DexterInd/GoPiGo/Projects/Empathybot/README.md

# Empathybot: The Raspberry Pi Robot That Reads Human Emotion

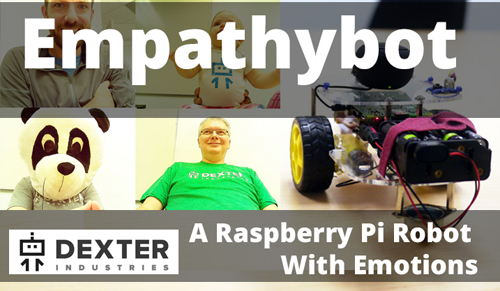
[picture p3: Projects/Empathybot/Empathybot.jpg]


In this project we built emotional intelligence to our robot.  We developed a Raspberry Pi Robot with the GoPiGo that will drive up to you, read your emotions, and then try to have a conversation with you, based on how you’re feeling.  We will show you how you too can build your own DIY emotion-reading robot with a Raspberry Pi.

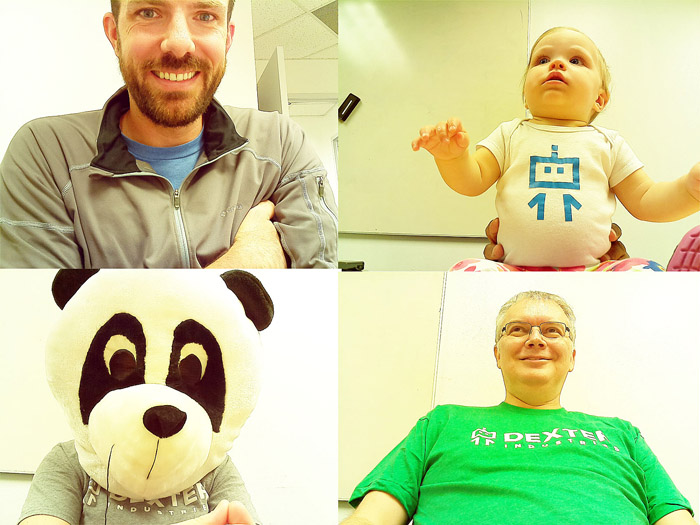
[picture p4: Projects/Empathybot/Emotions.jpg]


This folder contains the code you need to build Empathybot!  [You can see the full project here.](http://www.dexterindustries.com/projects/empathybot-raspberry-pi-robot-with-emotional-intelligence/)

# See Also

The GoPiGo is a delightful and complete robot for the Raspberry Pi that turns your Pi into a fully operating robot.  GoPiGo is a mobile robotic platform for the Raspberry Pi developed by [Dexter Industries.](http://www.dexterindustries.com/GoPiGo)  

- [Dexter Industries](http://www.dexterindustries.com/GoPiGo)
- [Kickstarter Campaign](http://kck.st/Q6vVOP)
- [Raspberry Pi](http://www.raspberrypi.org/)

## License
GoPiGo for the Raspberry Pi: an open source robotics platform for the Raspberry Pi.
Copyright (C) 2019  Dexter Industries

This program is free software: you can redistribute it and/or modify
it under the terms of the GNU General Public License as published by
the Free Software Foundation, either version 3 of the License, or
(at your option) any later version.

This program is distributed in the hope that it will be useful,
but WITHOUT ANY WARRANTY; without even the implied warranty of
MERCHANTABILITY or FITNESS FOR A PARTICULAR PURPOSE.  See the
GNU General Public License for more details.

You should have received a copy of the GNU General Public License
along with this program.  If not, see <http://www.gnu.org/licenses/gpl-3.0.txt>.
