DexterInd/GoPiGo/Projects/Alexabot/README.md

# [ Alexabot ](https://www.dexterindustries.com/projects/alexabot-amazon-alexa-controlled-robot/)

In this tutorial we build [Alexabot, the Amazon Alexa Controlled Robot, using the Raspberry Pi](https://www.dexterindustries.com/projects/alexabot-amazon-alexa-controlled-robot/).  We will walk through the steps of building a voice controlled robot with the Raspberry Pi and GoPiGo.  With Alexabot, you can command the Raspberry Pi Robot around with commands like “Alexa Forward!” or “Alexa Coffee!”.  GoPiGo is a mobile robotic platform for the Raspberry Pi developed by [Dexter Industries.](http://www.dexterindustries.com/GoPiGo)  

GoPiGo

This repository contains the code for the Alexabot Project for the GoPiGo.

GoPiGo

# See Also

- [Dexter Industries] (http://www.dexterindustries.com/GoPiGo)
- [Kickstarter Campaign] (http://kck.st/Q6vVOP)
- [Raspberry Pi] (http://www.raspberrypi.org/)

## License
GoPiGo for the Raspberry Pi: an open source robotics platform for the Raspberry Pi.
Copyright (C) 2016  Dexter Industries

This program is free software: you can redistribute it and/or modify
it under the terms of the GNU General Public License as published by
the Free Software Foundation, either version 3 of the License, or
(at your option) any later version.

This program is distributed in the hope that it will be useful,
but WITHOUT ANY WARRANTY; without even the implied warranty of
MERCHANTABILITY or FITNESS FOR A PARTICULAR PURPOSE.  See the
GNU General Public License for more details.

You should have received a copy of the GNU General Public License
along with this program.  If not, see <http://www.gnu.org/licenses/gpl-3.0.txt>.
