DexterInd/GoPiGo/Projects/GiftBot/README.md

# GiftBot

In this project, we'll show you GiftBot, the Raspberry Pi Robot that will deliver your Christmas Gifts and bring cheer to your holiday season.  We took the GoPiGo Raspberry Pi Robot, added some Jingle Bell Rock with the Raspberry Pi Speaker, and harnessed the power of three reindeer to deliver our gifts this year.  A elf will ride on the GoPiGo as it makes its rounds.

No reindeer robot would be complete without a Red Nosed Rudolf: we added one with a Red Grove LED!  GoPiGo is a mobile robotic platform for the Raspberry Pi developed by [Dexter Industries.](http://www.dexterindustries.com/GoPiGo)  

You can see [the full project for the GiftBot Raspberry Pi Robot here.](https://www.dexterindustries.com/projects/giftbot-raspberry-pi-robot-delivers-christmas-gifts/)

GoPiGo

This repository contains project examples for the GoPiGo.

GoPiGo

# See Also

- [Dexter Industries] (http://www.dexterindustries.com/GoPiGo)
- [Kickstarter Campaign] (http://kck.st/Q6vVOP)
- [Raspberry Pi] (http://www.raspberrypi.org/)

## License
GoPiGo for the Raspberry Pi: an open source robotics platform for the Raspberry Pi.
Copyright (C) 2016  Dexter Industries

This program is free software: you can redistribute it and/or modify
it under the terms of the GNU General Public License as published by
the Free Software Foundation, either version 3 of the License, or
(at your option) any later version.

This program is distributed in the hope that it will be useful,
but WITHOUT ANY WARRANTY; without even the implied warranty of
MERCHANTABILITY or FITNESS FOR A PARTICULAR PURPOSE.  See the
GNU General Public License for more details.

You should have received a copy of the GNU General Public License
along with this program.  If not, see <http://www.gnu.org/licenses/gpl-3.0.txt>.
