DexterInd/GoPiGo/Software/Python/Examples/Basic_Robot_Control_GUI/README.md

## Basic Robot Control GUI
### Basic example for controlling the GoPiGo using the Keyboard and a GUI on VNC

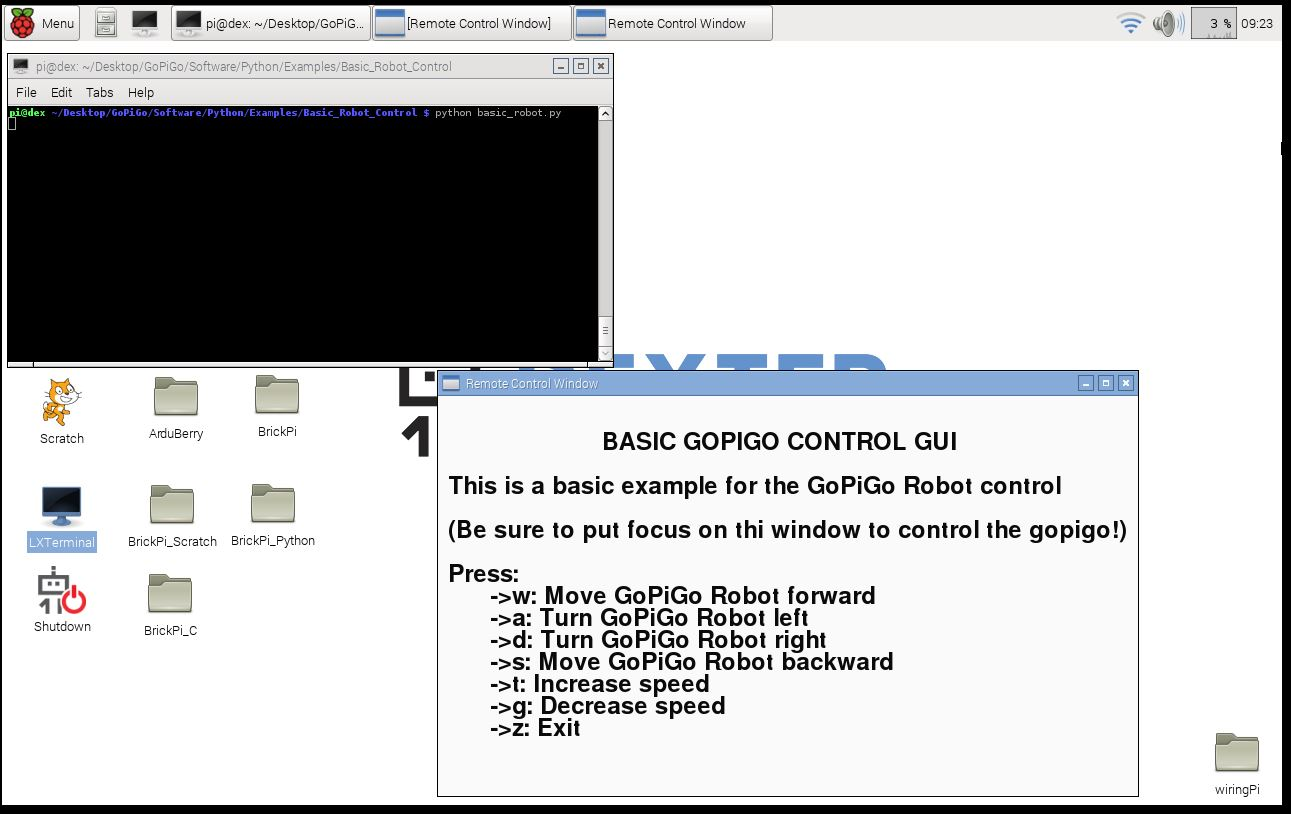
[picture p9: Software/Python/Examples/Basic_Robot_Control_GUI/Basic_Raspberry_Pi_Robot_Control_GUI.jpg]
Basic Robot Control GUI GoPiGo Rasberry Pi Robot Controlled with a GUI


Contributed by casten on Gitub https://github.com/DexterInd/GoPiGo/pull/112

**Control:**

- w:	Move forward
- a:	Turn left
- d:	Turn right
- s:	Move back
- x:	Stop
- t:	Increase speed
- g:	Decrease speed
- z: 	Exit

**Usage:**
Open LXTerminal in VNC or Pi Desktop

Go to the example folder:

`cd Desktop/GoPiGo/Software/Python/Examples/Basic_Robot_Control/GUI`

Run the example:

`python basic_robot_gui.py`

GoPiGo

This repository contains source code, firmware and design materials for the GoPiGo.

GoPiGo

# See Also

- [Dexter Industries](http://www.dexterindustries.com/GoPiGo)
- [Kickstarter Campaign](http://kck.st/Q6vVOP)
- [Raspberry Pi](http://www.raspberrypi.org/)

## License
GoPiGo for the Raspberry Pi: an open source robotics platform for the Raspberry Pi.
Copyright (C) 2015  Dexter Industries

This program is free software: you can redistribute it and/or modify
it under the terms of the GNU General Public License as published by
the Free Software Foundation, either version 3 of the License, or
(at your option) any later version.

This program is distributed in the hope that it will be useful,
but WITHOUT ANY WARRANTY; without even the implied warranty of
MERCHANTABILITY or FITNESS FOR A PARTICULAR PURPOSE.  See the
GNU General Public License for more details.

You should have received a copy of the GNU General Public License
along with this program.  If not, see <http://www.gnu.org/licenses/gpl-3.0.txt>.
