DexterInd/GoPiGo/Software/Python/Examples/Basic_Servo/README.md

## basic_servo.py
### This example demonstrates controlling the Servo on the GoPiGo robot.
In this example, we control the servo with a keyboard. 
- Press "a" to move the servo left
- Press "d" to move the servo right
- Press "s" to move the servo to home position

GoPiGo

This repository contains source code, firmware and design materials for the GoPiGo.

GoPiGo

# See Also

- [Dexter Industries](http://www.dexterindustries.com/GoPiGo)
- [Kickstarter Campaign](http://kck.st/Q6vVOP)
- [Raspberry Pi](http://www.raspberrypi.org/)

## License
GoPiGo for the Raspberry Pi: an open source robotics platform for the Raspberry Pi.
Copyright (C) 2015  Dexter Industries

This program is free software: you can redistribute it and/or modify
it under the terms of the GNU General Public License as published by
the Free Software Foundation, either version 3 of the License, or
(at your option) any later version.

This program is distributed in the hope that it will be useful,
but WITHOUT ANY WARRANTY; without even the implied warranty of
MERCHANTABILITY or FITNESS FOR A PARTICULAR PURPOSE.  See the
GNU General Public License for more details.

You should have received a copy of the GNU General Public License
along with this program.  If not, see <http://www.gnu.org/licenses/gpl-3.0.txt>.
