DexterInd/GoPiGo/Software/Python/Examples/Browser_Streaming_Robot/README.md

## Browser streaming bot
### This example is for streaming video and controlling the GoPiGo from a web browser

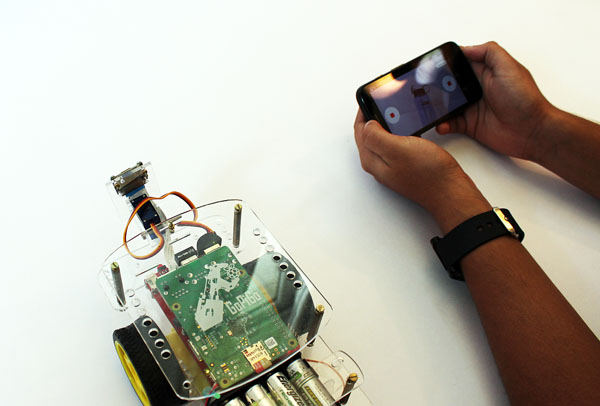
[picture p10: Software/Python/Examples/Browser_Streaming_Robot/Raspberry_Pi_Camera_controlled-by-mobile-browser.jpg]
Mobile control of the GoPiGo Raspberry Pi Robot Control of the GoPiGo Raspberry Pi Robot with a mobile phone.


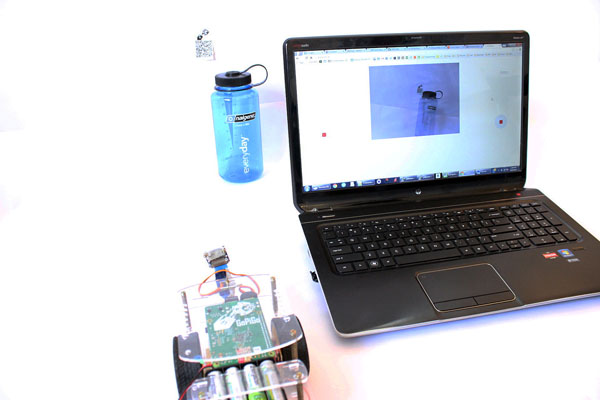
[picture p11: Software/Python/Examples/Browser_Streaming_Robot/Raspberry_Pi_Camera_streaming-to-computer-browser.jpg]
Robot Control and streaming through the browser Streaming video through the browser of the GoPiGo


Controlling the GoPiGo robot with a mobile phone Streaming video from your Raspberry Pi Robot to your mobile phone.

**Usage:**
- Make robot_web_server.py executable

 >      sudo chmod +x robot_web_server.py

- Run robot_web_server.py

 >      sudo ./robot_web_server.py
 
- Open a web browser on any computer or mobile device and enter the following in the address bar:

 >      dex.local:98
The page runs on dex.local or the IP address of the Pi on port 98

- The video stream would load up and you can use the joystick on the screen to control the GoPiGo

GoPiGo

This repository contains source code, firmware and design materials for the GoPiGo.

GoPiGo

# See Also

- [Dexter Industries](http://www.dexterindustries.com/GoPiGo)
- [Kickstarter Campaign](http://kck.st/Q6vVOP)
- [Raspberry Pi](http://www.raspberrypi.org/)

## License
GoPiGo for the Raspberry Pi: an open source robotics platform for the Raspberry Pi.
Copyright (C) 2017  Dexter Industries

This program is free software: you can redistribute it and/or modify
it under the terms of the GNU General Public License as published by
the Free Software Foundation, either version 3 of the License, or
(at your option) any later version.

This program is distributed in the hope that it will be useful,
but WITHOUT ANY WARRANTY; without even the implied warranty of
MERCHANTABILITY or FITNESS FOR A PARTICULAR PURPOSE.  See the
GNU General Public License for more details.

You should have received a copy of the GNU General Public License
along with this program.  If not, see <http://www.gnu.org/licenses/gpl-3.0.txt>.
