DexterInd/GoPiGo/Software/Python/Examples/Mouse_Control/README.md

## Mouse Control
### This example controls the GoPiGo with a wireless mouse on the USB port.

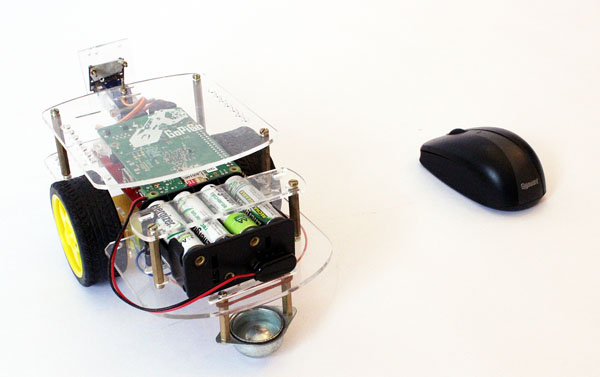
[picture p13: Software/Python/Examples/Mouse_Control/GoPiGo-Mouse-Control-with-Raspberry-Pi.jpg]
Control the Raspberry Pi Robot with a mouse. Control the Raspberry Pi Robot with a mouse.


**mouse_control_movement.py**

- Move the mouse up, down, left or right to control the GoPiGo
- Press the Left mouse button to stop

**mouse_control_movement.py**

- Press _any mouse_ button to start moving
- Press the _Left mouse_ button to turn left
- Press the _Right mouse_ button to turn right
- Press the _Middle mouse_ button to stop
- Press both _left and right mouse_ button to move back

GoPiGo

This repository contains source code, firmware and design materials for the GoPiGo.

GoPiGo

# See Also

- [Dexter Industries](http://www.dexterindustries.com/GoPiGo)
- [Kickstarter Campaign](http://kck.st/Q6vVOP)
- [Raspberry Pi](http://www.raspberrypi.org/)

## License
GoPiGo for the Raspberry Pi: an open source robotics platform for the Raspberry Pi.
Copyright (C) 2017  Dexter Industries

This program is free software: you can redistribute it and/or modify
it under the terms of the GNU General Public License as published by
the Free Software Foundation, either version 3 of the License, or
(at your option) any later version.

This program is distributed in the hope that it will be useful,
but WITHOUT ANY WARRANTY; without even the implied warranty of
MERCHANTABILITY or FITNESS FOR A PARTICULAR PURPOSE.  See the
GNU General Public License for more details.

You should have received a copy of the GNU General Public License
along with this program.  If not, see <http://www.gnu.org/licenses/gpl-3.0.txt>.
