DexterInd/GoPiGo/Projects/AgentKK/README.md

# Agent KK Guard Robot

Build and program this little GoPiGo to protect your wardrobe, your closet, or even your whole room! Hide GoPiGo behind a closed door and when the door is opened, it will attack your siblings, scaring them, and even taking a picture as trespassing proof! That way, even mom will have to be on your side! 

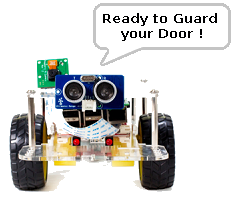
[picture p16: Projects/AgentKK/ReadyToGuardYourDoor.png]
GoPiGo


This repository contains the code for this project in both Python and Scratch. 
The sound effect comes from https://www.freesound.org/

The project is documented at [AgentKK](http://www.dexterindustries.com/projects/agent-kk-2/)

GoPiGo is documented at [GoPiGo](http://www.dexterindustries.com/shop/gopigo-starter-kit-2/)

# See Also

- [Dexter Industries](http://www.dexterindustries.com/GoPiGo)
- [Kickstarter Campaign](http://kck.st/Q6vVOP)
- [Raspberry Pi](http://www.raspberrypi.org/)

## License
GoPiGo for the Raspberry Pi: an open source robotics platform for the Raspberry Pi.
Copyright (C) 2016  Dexter Industries

This program is free software: you can redistribute it and/or modify
it under the terms of the GNU General Public License as published by
the Free Software Foundation, either version 3 of the License, or
(at your option) any later version.

This program is distributed in the hope that it will be useful,
but WITHOUT ANY WARRANTY; without even the implied warranty of
MERCHANTABILITY or FITNESS FOR A PARTICULAR PURPOSE.  See the
GNU General Public License for more details.

You should have received a copy of the GNU General Public License
along with this program.  If not, see <http://www.gnu.org/licenses/gpl-3.0.txt>.
