DexterInd/GoPiGo/Software/Python/control_panel/GoPiGo.png

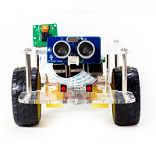
Software/Python/control_panel/GoPiGo.png
