DexterInd/GoPiGo/Software/Python/Examples/Browser_Streaming_Robot/Raspberry_Pi_Camera_streaming-to-mobile-browser.jpg

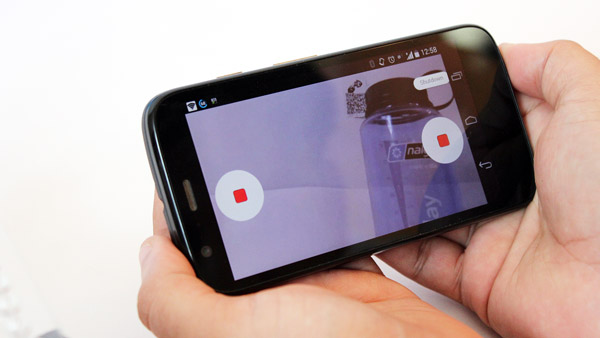
Software/Python/Examples/Browser_Streaming_Robot/Raspberry_Pi_Camera_streaming-to-mobile-browser.jpg
