DexterInd/GoPiGo/Assembly_and_Programming/README.md

# GoPiGo Assembly and Programming Instructions

The GoPiGo is a delightful and complete robot for the Raspberry Pi that turns your Pi into a fully operating robot.  GoPiGo is a mobile robotic platform for the Raspberry Pi developed by [Dexter Industries.](http://www.dexterindustries.com/GoPiGo)  

GoPiGo

# Assembly and Programming Files

These files were originally hosted on the Dexter Industries website.  With the introduction of the GoPiGo3, we have migrated all assembly and startup instructions to Github in PDF format.  

You can find a series of helpful videos for assembling and getting started with the GoPiGo1 and GoPiGo2 on Youtube:
1. [Assemble the GoPiGo1](https://www.youtube.com/playlist?list=PLGXEJ4Ye1qCOs-fSJRosUp4GyvH-XZrSS)
2. [Assemble the GoPiGo2](https://www.youtube.com/playlist?list=PLGXEJ4Ye1qCP_hewmQsEGqpzLr0Ydy8_O)
3. [Connect to the GoPiGo2](https://www.youtube.com/playlist?list=PLGXEJ4Ye1qCNZ9OGYTXh7o8jSgO5-NHjY).

# See Also

- [The GoPiGo3](http://www.dexterindustries.com/GoPiGo)
- [Dexter Industries Forum Support](http://forum.dexterindustries.com/c/gopigo)
- [Kickstarter Campaign](http://kck.st/Q6vVOP)
- [Raspberry Pi](http://www.raspberrypi.org/)

## License
GoPiGo for the Raspberry Pi: an open source robotics platform for the Raspberry Pi.
Copyright (C) 2017  Dexter Industries

This program is free software: you can redistribute it and/or modify
it under the terms of the GNU General Public License as published by
the Free Software Foundation, either version 3 of the License, or
(at your option) any later version.

This program is distributed in the hope that it will be useful,
but WITHOUT ANY WARRANTY; without even the implied warranty of
MERCHANTABILITY or FITNESS FOR A PARTICULAR PURPOSE.  See the
GNU General Public License for more details.

You should have received a copy of the GNU General Public License
along with this program.  If not, see <http://www.gnu.org/licenses/gpl-3.0.txt>.
