DexterInd/GoPiGo/Assembly_and_Programming/GoPiGo2/Assembly_and_Getting_Started/dexterindustries.com-Add trim to the motors.pdf

# Add trim to the motors

dexterindustries.com/GoPiGo/programming__trashed/python-programming-for-the-raspberry-pigopigo__trashed/add-trim-to-the-motors/ (https://www.dexterindustries.com/GoPiGo/programming__trashed/python-programming-for-the-raspberry-pi-gopigo__trashed/add-trim-to-the-motors/)

If you find that your GoPiGo starts turning a bit when it moves forward then this is something for you.

We have added a trim function in the Firmware and the software from firmware v1.3 on wards so that you can increase or decrease the speed of one of the wheels just by a bit (add trim) so it does not turn by a lot when it is moving forward. The GoPiGo usually starts going a bit left or right because of a lot of external factors like the wheel alignment, motor placement, friction etc.

Here is how to use trim with your GoPiGo.

Before you start, make sure that you disconnect the motors. When the firmware update is done and you have verified that it has upgraded, connect the motors again.

Make sure that you have updated to firmware v1.3.

cd Desktop/GoPiGo/Firmware sudo chmod +x firmware_update.sh

sudo ./firmware_update.sh

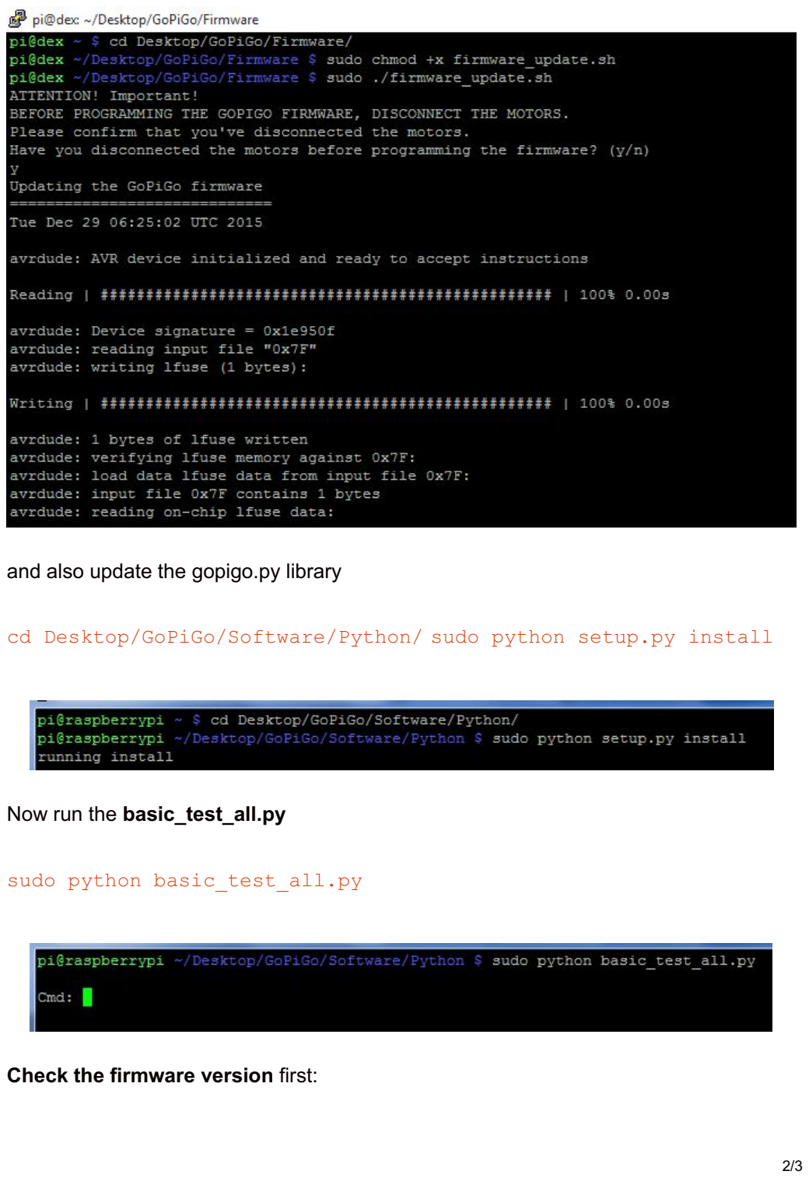
[picture p62: page 2]

and also update the gopigo.py library

cd Desktop/GoPiGo/Software/Python/ sudo python setup.py install

Now run the basic_test_all.py

sudo python basic_test_all.py

Check the firmware version first:

Then check for the trim value with the tr command:

Now you should try various trim values to see what works for you.

A trim value of 0 means that the left motor will run at
the same speed as the right motor.
A trim value of 50 means that the left motor will run at the 150% the speed of the right motor and the GoPiGo will turn more towards the right. This can be used to compensate for the GoPiGo normally turning left when it is supposed to go right. A trim value of -50 means that the left motor will run at the 50% the speed of the right motor and the GoPiGo will turn more towards the left. This can be used to compensate for the GoPiGo normally turning right when it is supposed to go left. Start with small trim values in multiple of 5 and find out the value that works for you
Give w to move forward and x to stop to test the trim values

Once you have found the trim value that
works best for you, write it to the
EEPROM so that the GoPiGo uses
them whenever it starts:

Give tw as the command and enter the
desired trim value. If it reports back that
the value in EEPROM is the same as the value you gave, that means that you have set the values correctly.

The values revert back to 0 whenever yo do a firmware update.
