DexterInd/GoPiGo/Assembly_and_Programming/GoPiGo2/Assembly_and_Getting_Started/dexterindustries.com-Attaching a Camera or Ultrasonic Sensor.pdf

# Attaching a Camera or Ultrasonic Sensor

dexterindustries.com/GoPiGo/getting-started-with-your-gopigo-raspberry-pi-robot-kit-2/attaching-a-cameraor-ultrasonic-sensor-raspberry-pi-robot-kit/ (https://www.dexterindustries.com/GoPiGo/getting-started-with-your-gopigo-raspberry-pi-robot-kit-2/attaching-a-camera-or-ultrasonic-sensor-raspberry-pi-robot-k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)

How to turn your Raspberry Pi into a Camera or ultrasonic sensor guided robot.

### Attach the Raspberry Pi Camera With the Servo

Start with the Raspberry Pi Camera.

This tutorial assumes you have already built
the servo package. For instructions on building the servo package please see this. (https://www.dexterindustries.com/GoPiGo/getting-started-with-your-gopigo-raspberry-pi-robot-kit/1-assemble-the-gopigo/assemble-servo-package-assemble-the-rasp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)

Attach the camera to the faceplate of the servo package using two of the small screws
attached. You can properly space the camera
from the servo faceplate by attaching the

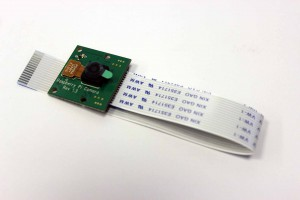
[picture p85: figure]

screws to the camera first, then attaching a nut against the camera.

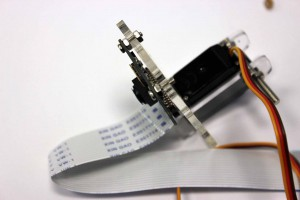
[picture p86: figure]

Attach the camera to the faceplate.

Connecting the servo to the GoPiGo board. Note the orientation of the brown wire.

### Attach the Camera Directly to the Chassis

### Attach the Ultrasonic Sensor

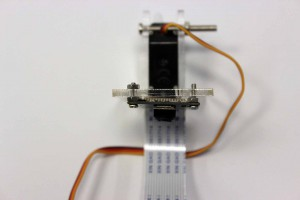
[picture p87: figure]

The ultrasonic sensor can be attached to the servo faceplate with two of the screws that come with the servo package. The ultrasonic sensor has two screw holes to allow for attaching.

Connect the servo to the GoPiGo Board.

### Questions about the Raspberry Pi Robot Kit?

Please ask away on our forums! (https://www.dexterindustries.com/forum/?forum=gopigo)

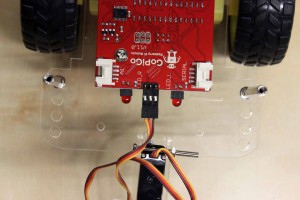
[picture p88: figure]
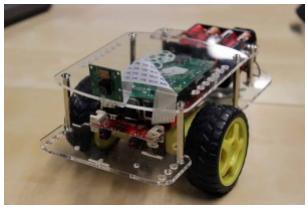
[picture p89: figure]

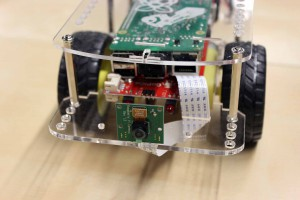
[picture p90: figure]

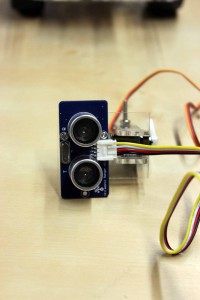
[picture p91: figure]
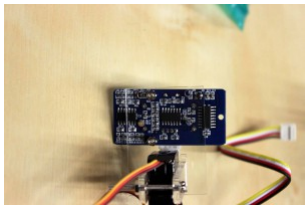
[picture p92: figure]
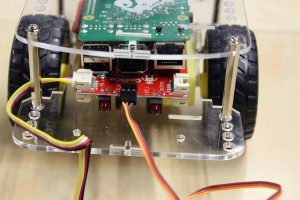
[picture p93: figure]
