DexterInd/GoPiGo/Assembly_and_Programming/GoPiGo2/Assembly_and_Getting_Started/dexterindustries.com-Get Started With the GoPiGo.pdf

# Get Started With the GoPiGo

dexterindustries.com/GoPiGo/getting-started-with-your-gopigo-raspberry-pi-robot-kit-2/

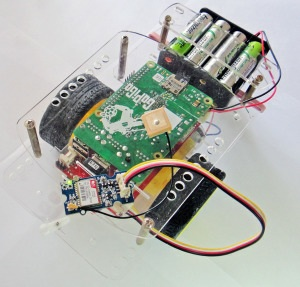
[picture p94: figure]

Congratulations on getting a GoPiGo
Raspberry Pi Robot Kit!

This page and the sub-pages will help walk you through getting it setup and started. We recommend you go through each page, in the following order:

1. Assemble the GoPiGo (https://www.dexterindustries.com/GoPiGo/1-assemble-the-gopigo/) Raspberry Pi Robot Kit & Servo.
2. Setting up the SD Card. (https://www.dexterindustries.com/GoPiGo/sdcard/)
3. Powering Up the GoPiGo. (https://www.dexterindustries.com/GoPiGo/3-power-up/)
4. Connect to the GoPiGo. (https://www.dexterindustries.com/GoPiGo/4-connect-to-the-gopigo/)
5. Booting the GoPiGo for the first time. (https://www.dexterindustries.com/GoPiGo/5-using-your-gopigo-for-the-first-time/)

After you have completed all the steps above, you can check out the Examples and Projects that we have made and try them out yourself or make something cool and (https://www.dexterindustries.com/GoPiGo/learning/python-examples-for-the-raspberry-pi/) share it with the community.

Have a question or a suggestion? Go check out our forums here. (http://forum.dexterindustries.com/)

1/1
