DexterInd/GoPiGo/Assembly_and_Programming/GoPiGo2/Programming/Python/dexterindustries.com-fw_ver.pdf

# fw_ver()

dexterindustries.com/GoPiGo/learning-2/python-programming-for-the-raspberry-pi-gopigo/fw_ver/

### Read the firmware version of the GoPiGo

Read the firmware version of the GoPiGo.

It can be from 0.9 onwards.

1.0 is the latest firmware

Syntax

fw_ver()

Parameter:

None

Return:

Firmware version on success

-1 on failure

Example

from gopigo import *
print fw_ver()

1/1
