DexterInd/GoPiGo/Assembly_and_Programming/GoPiGo2/Programming/Python/dexterindustries.com-Read communication timeoutnbspstatus.pdf

# Read communication timeout status

dexterindustries.com/GoPiGo/learning-2/python-programming-for-the-raspberry-pigopigo/read_timeout_status/ (https://www.dexterindustries.com/GoPiGo/learning-2/python-programming-for-the-raspberry-pi-gopigo/read_timeout_status/)

Reads status register on the GoPiGo and returns the status of the communication timeout

Syntax

read_timeout_status()

Parameter:

None

Return:

0 if the communication timeout has occurred, else 1

Example

from gopigo import *
print read_timeout_status()

1/1
