DexterInd/GoPiGo/Assembly_and_Programming/GoPiGo2/Programming/Python/dexterindustries.com-Read encoder targeting status.pdf

# Read encoder targeting status

dexterindustries.com/GoPiGo/learning-2/python-programming-for-the-raspberry-pigopigo/read_enc_status/ (https://www.dexterindustries.com/GoPiGo/learning-2/python-programming-for-the-raspberry-pi-gopigo/read_enc_status/)

Reads status register on the GoPiGo and returns the status of the encoder targeting

Syntax

read_enc_status()

Parameter:

None

Return:

0 if encoder target is reached, else 1

Example

from gopigo import *
print read_enc_status()

1/1
