DexterInd/GoPiGo/Assembly_and_Programming/GoPiGo2/Programming/Python/dexterindustries.com-Read encoder values.pdf

# Read encoder values

dexterindustries.com/GoPiGo/learning-2/python-programming-for-the-raspberry-pi-gopigo/read-encodervalues/ (https://www.dexterindustries.com/GoPiGo/learning-2/python-programming-for-the-raspberry-pi-gopigo/read-encoder-values/)

GoPiGo Firmware update 1.3 onward, it is now possible to access the encoder vales easily.

Just make sure that you are using firmware version 1.3 and goto the Software/Python folder on your Pi

cd Desktop/GoPiGo/Software/Python/

and run the encoder read example:

sudo python enc_val_read.py

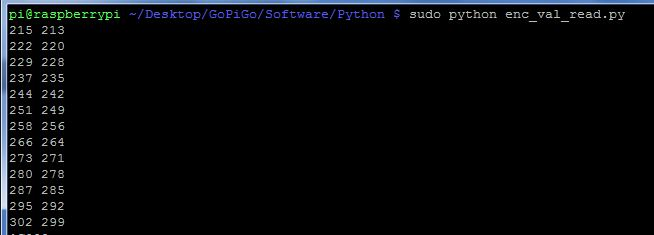
[picture p95: figure]

It gives you the values for both the encoders. 18 counts on the encoder correspond to 1 rotation of the wheel.

1/1
