DexterInd/GoPiGo/Assembly_and_Programming/GoPiGo2/Programming/Python/dexterindustries.com-Installing the GoPiGo Python Library.pdf

# Installing the GoPiGo Python Library

dexterindustries.com/GoPiGo/learning-2/python-programming-for-the-raspberry-pi-gopigo/installinggopigo-python-library/ (https://www.dexterindustries.com/GoPiGo/learning-2/python-programming-for-the-raspberry-pi-gopigo/installing-gopigo-python-library/)

If you are using the Dexter Industries SD card or the Dexter Industries Image, then the GoPiGo library comes preinstalled with the SD card.

If you are using your own version of Raspbian then you will have to install the Python Library

To install the GoPiGo library:

1. Clone the GoPiGo Repository from Github

sudo git clone https://github.com/DexterInd/GoPiGo.git

2. Go to the Python folder cd GoPiGo/Software/Python/
3. Install the python library sudo python setup.py install

1/2

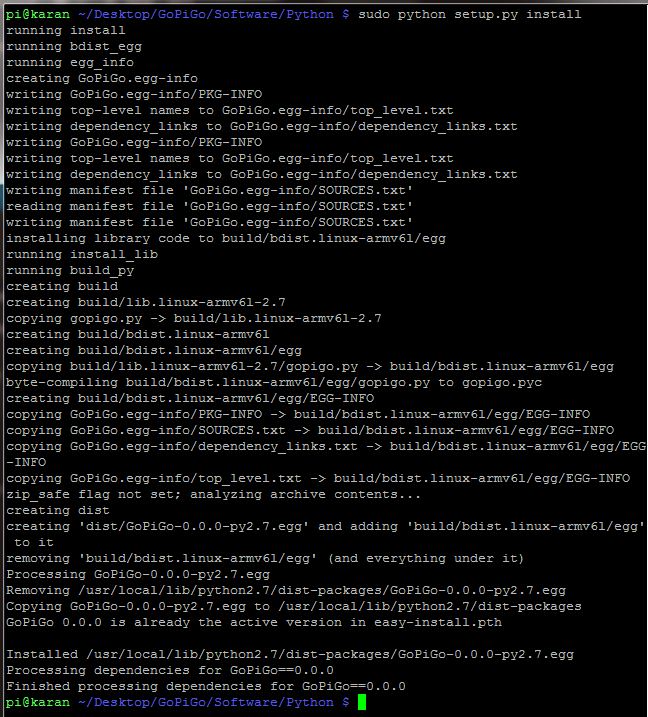
[picture p104: figure]

The library should be installed now.

Go over to the example section (https://www.dexterindustries.com/GoPiGo/learning/python-examples-for-the-raspberry-pi/) and try out some examples.

Have a question or a suggestion? Go check out our support page here (https://www.dexterindustries.com/GoPiGo/learning/) or post it on the forums here. (https://www.dexterindustries.com/forum/?forum=gopigo)

2/2
