DexterInd/GoPiGo/(threads)

Thread 20 (2014-07-08):

Improving the stability of encoder targetting

karan259, 2014-07-08:

Closed 2022-03-07.

Thread 21 (2014-07-09):

Problem with PIDafter stopping

karan259, 2014-07-09:
If motor 1 slow down and stops, motor 2 does the same but Motor 2 does not start after motor 1 starts

Closed 2015-01-12.

Thread 38 (2015-01-12):

Motor Turning at different rates and sometime stalling

karan259, 2015-01-12:
Refer to forums http://www.dexterindustries.com/forum/?reply=3787

karan259, 2015-01-12:
Solution for now is to switch to Normal running mode without PID for default and keep looking into the issue.

Closed 2015-01-12.

Thread 52 (2015-05-16):

Firmware version mismatch

BandonRandon, 2015-05-16:
Today I got out my GoPiGo and noticed that v13 of the firmware was available on GitHub. I did a manual update to v13.

I then ran the Dexter Industries Update script that comes with the DI version of Raspian and that reverted the firmware back to v12

I'm not sure if there is a difference between these two versions but it may make sense to have the auto updater grab v13 instead of v12.

karan259, 2015-05-18:
The stable version for the GoPiGo firmware is v12 so that's why the DI script uses it. We'll be switching to v13 in the coming days and make it official. After that the default should be v13

Closed 2015-10-29.

Thread 66 (2015-07-11):

vnc + gopigo = crash

spraints, 2015-07-11:
If I ssh to my gopigo robot and run `cd Desktop/GoPiGo/Software/Python/Examples/Basic\ Robot\ Control/; sudo python basic_robot.py`, everything works right. If I use vnc to connect, and run the same thing in a terminal, the raspberry pi crashes as soon as I make the robot do anything (e.g. `w` to make it go forward).

I'm probably doing something wrong, but I don't know where to start debugging.

DexterInd, 2015-07-13:
Hey spraints, we'll give this a shot.  Haven't seen this before.

DexterInd, 2015-07-14:
Hey spraints, just tried this to make sure I wasn't going crazy.  Worked just fine for me.  I wonder if your batteries are weak or low?  Can you try powering with a USB wall plug, as well as the batteries, in case that's the problem?  Or do you have a way to test the batteries?

spraints, 2015-07-14:
> Can you try powering with a USB wall plug, as well as the batteries, in case that's the problem?

I've been using a wall plug, but I don't think it's the highest amperage plug that I've got. Also, I was using a usb wireless network adapter, which I assume draws some current too. I won't be able to try for a couple of days, but I'll let you know if I can get it working by changing the power supply or network connection.

DexterInd, 2015-07-14:
Using the wall plug and a battery pack at the same yime?  That's what I
would try first, or just using batteries alone.  You may be seeing the pi
reset because of amperage draw.  If you use the wall plug alone, and the
motors and no battery, you could burn out the pi and or the gopigo.
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

spraints, 2015-07-21:
Ah, that was it. I put fresh batteries in it today, and it runs around the floor just fine. Thanks!

Closed 2015-07-21.

Thread 67 (2015-07-15):

Change License to GNU GPL3

DexterInd, 2015-07-15:
Hey folks,
We had a request to change this license from Creative Commons over to GNU GPL3. I wanted to propose it and make sure everyone is ok with it before I make the change.

http://www.gnu.org/licenses/gpl-3.0.txt

Please sound off!

DexterInd, 2015-07-27:
Closing this issue and switching to GPL3!

Closed 2015-07-27.

Thread 98 (2015-10-29):

Servo jitter reduction with a user defined function call

karan259, 2015-10-29:
http://www.dexterindustries.com/topic/servo-jitters/

Closed 2022-03-07.

Thread 135 (2016-04-17):

[Question] reverse proxy

hamzux, 2016-04-17:
Hello,

I just setup my GoPiGo to run the browser streaming app. I want to access it when away from home through another machine running nginx as a reverse proxy (ssl enabled + authentication).

Here's my nginx config :

`
location / {
  if ($scheme = http) {
   rewrite ^ https://$server_name$request_uri? permanent;
  }

  proxy_redirect          off;
  proxy_set_header        Host            $host;
  proxy_set_header        X-Real-IP       $remote_addr;
  proxy_set_header        X-Forwarded-For $proxy_add_x_forwarded_for;
  proxy_hide_header       X-Powered-By;
  proxy_intercept_errors on;
  proxy_buffering on;

  proxy_cache_key "$scheme://$host$request_uri";
  proxy_pass http://localIP:98;
}
`

I tested it and I can see the web page of the app but the camera does not show (it's running on port 8080 and not 98)

Any idea how to setup this?

Thanks.

DexterInd, 2016-04-18:
Are you trying to use this example: https://github.com/DexterInd/GoPiGo/blob/master/Software/Python/Examples/Browser_Streaming_Robot/robot_web_server.py

Or a different one for web control?

hamzux, 2016-04-18:
yes I'm trying to use this example

thanks :)

Closed 2016-05-05.

Thread 143 (2016-05-21):

pip upgrade stops gopigo working as expected

Rumbles, 2016-05-21:
I have my GoPiGo setup, I thought it might be an idea to update my pip install of gopigo, so I did pip install gopigo ---upgrade, this barfed, so I removed and reinstalled gopigo with pip. I tried using gopigo in the console after both and each time I got:

```
>>> gopigo.fwd()
Traceback (most recent call last):
File "<stdin>", line 1, in <module>
AttributeError: 'module' object has no attribute 'fwd'
>>> print(gopigo.__file__)
/usr/local/lib/python2.7/dist-packages/gopigo/__init__.pyc
```

Previously the file showed as:

`/usr/local/lib/python2.7/dist-packages/GoPiGo-0.0.0-py2.7.egg/gopigo.pyc`

I would expect this to work, and after reinstalling by running GoPiGo/Software/Python/setup.py install and gopigo has reverted to the old version it does work.

Is this expected behaviour?

CleoQc, 2016-09-21:
pip install currently installs a very old version. It has not been kept up to date

Closed 2020-05-18.

Thread 184 (2016-11-17):

C# Library exceptions

muziekklas, 2016-11-17:
We are experimenting for a hackaton with the GoPiGo and Raspi 3.
We installed the latest and greatest Windows 10 IOT on the Pi and try to run this simple background task we made:
`C#
            _goPiGo.MotorController().Stop();
            try{
                System.Diagnostics.Debug.WriteLine(Sensor.MeasureInCentimeters());
            }catch(Exception e)
            {
                System.Diagnostics.Debug.WriteLine("[ERR]:" + e.ToString() + "\n");
            }
`

The Exception is the following:
Unexpected number of bytes was transferred. Expected: '. Actual: '.
   at Windows.Devices.I2c.I2cDevice.Write(Byte[] buffer)
   at GoPiGo.Sensors.UltrasonicRangerSensor.MeasureInCentimeters()
   at BackDriveme.StartupTask.RandomMovement()

Also when we set the motor direction, it sometimes shoots a FileNotFoundException.

Also how "Up-To-Date" and bug-free is the library? Is it compatible with the latest Windows IOT, Raspi3 and the GoPiGo 2 board?

muziekklas, 2016-11-17:
the filenotfound exception:
[ERR]:System.IO.FileNotFoundException: The system cannot find the file specified.

muziekklas, 2016-11-28:
I am reworking the C# library for Mono (https://github.com/muziekklas/GoPiGo.mono) which already seem to work and for the WinIOT, which is still buggy: https://github.com/muziekklas/GoPiGo.Net
Feel free to contribute!

Closed 2016-11-28.

Thread 209 (2017-02-27):

IOException:  Error reading from I2CDevice on I2CBus '1' ('/dev/i2c-1') at address 0x8 to address 0x1.  Got '-1'.

kpolleck, 2017-02-27:
After getting my new GoPiGo2 Robot working with the Python example, I tried to set up the Java library, but when running Test.sh, I get the immediate error:

IOException:  Error reading from I2CDevice on I2CBus '1' ('/dev/i2c-1') at address 0x8 to address 0x1.  Got '-1'.

The java program doesn't exit, and movement commands seem to still work (move forward / move backward / turn right / turn left / etc.) but other commands (e.g. led commands, "board revision," etc.) fail--some of them causing the java program to exit.

I'm wondering...is it possible that whomever wrote this had other accessories attached which might avoid the IOExceptions I am seeing?

DexterInd, 2017-02-27:
@marcellobarile , do you have any idea what might have happened?

marcellobarile, 2017-02-27:
hi @kpolleck,
can you please tell me the firmware version which is installed on your GoPiGo? I'll try to reproduce the issue with your version.

Best regards

kpolleck, 2017-03-01:
Thanks.  It's a GoPiGo2.  I'll have to check it when I'm home and let you know.

While we are waiting for that, I'm wondering this:  This error occurs  every minute or two while everything is idle. Is there some sort of polling in the java library?

marcellobarile, 2017-03-01:
Hello @kpolleck,
it might be the voltage checkng timer (which ticks every minute).

I look forward to knowing the details of your environment (if possible can you also provide some OS information + Java version, thanks); consider that there might be some breaking change in the newer releases of the pi4j library.

Have a nice day

marcellobarile, 2017-03-01:
Nice catch @kpolleck, I was unaware of that thread... I'd say that it might be worthy to give it a try but, if you prefer, I can dig into it a little bit.

kpolleck, 2017-03-03:
The baudrate change resolved the problem.

For the record, my other information is:

Robot:  GoPiGo2

Pi:  Raspberry Pi3

Firmware version::1.6

Board revision:826

Java:
Java(TM) SE Runtime Environment (build 1.8.0_65-b17)
Java HotSpot(TM) Client VM (build 25.65-b01, mixed mode)

marcellobarile, 2017-03-05:
awesome @kpolleck! @DexterInd do you think is there something that I can do codewise? Are you guys aware of this case?

DexterInd, 2017-03-07:
@karan259 ?

Thread 210 (2017-02-27):

"Permission denied" when running compile.sh and Test.sh

kpolleck, 2017-02-27:
When running the just-installed compile.sh and Test.sh for the first time, I got "permission denied" errors even when running as root.

To fix this, I did:
  chmod 777 compile.sh
  chmod 777 Test.sh
to set the ExECUTE permission.

DexterInd, 2017-02-27:
Hi @kpolleck , do you think we should add these commands into the readme for java?  Thanks for sharing the solution!

marcellobarile, 2017-02-27:
Good morning @kpolleck,
I was wondering, as asked in other issues, if you are using some kind of pre-installed environment or if you have just checked out the repo from GitHub.

Thanks and have a nice day

kpolleck, 2017-03-01:
Nothing special.  My 15-year-old son and I pretty much just assembled the kit (RaspberryPi 3 + GoPiGo2), connected a TV to the HDMI port to configure the wireless, connected via VNC and ran the python routes successfully.

Then, being Java fans, we ran:

curl -s get.pi4j.com | sudo bash

...and followed the rest of the steps in https://github.com/DexterInd/GoPiGo/tree/master/Software/Java

marcellobarile, 2017-03-01:
Alright @kpolleck, thank you so much for the effort that you and your son are putting into this :) First of all I'll try a fresh installation with the most recent pi4j release then I'll give you an update as soon as I come up with more clues, if anything pops out from your side don't hesitate to update the issue.

Have a nice evening

marcellobarile, 2017-03-01:
@kpolleck thank you so much for the effort that you and your son are putting into this :-) Actually you are right and you did nothing wrong; the scripts comes out with no execution rights.. which means it should be nice to specify, in the readme file, that those are supposed to be set.

Just checked out and copied/pasted as confirm:
-rw-rw-r-- 1 marcello marcello  146 Feb 28 23:47 Test.sh
-rw-rw-r-- 1 marcello marcello  327 Feb 28 23:47 compile.sh

Thank you again for having pointed it out and have a nice evening

DexterInd, 2017-03-02:
Sounds like a great solution to me.  We could combine the installation step and setting the permissions to all of these into a bash script.  This way a user can just run an install script once, rather than do all the commands.  We can do that if you think it will help, let me know!

Closed 2022-03-07.

Thread 211 (2017-02-27):

Board.java won't compile...Un

kpolleck, 2017-02-27:
When first compiling the java classes, I got an error related to uncaught Exceptions in Board.java.  I don't quite understand how this worked for anyone as it is.

To fix this, I added try/catch code around line 91 to:

I2CBus bus = null;
try {
    bus = I2CFactory.getInstance(busId);
} catch (Exception e) {
    System.out.println(e);
}
device = bus.getDevice(ADDRESS);

DexterInd, 2017-02-27:
@kpolleck thanks for sharing the fix you have here.  Could you submit a PR for this?  Also, what version of the operating system are you using; Raspbian or Rasbian for Robots?

marcellobarile, 2017-02-27:
hi @kpolleck,
in addition, I'd also like to know something more about your environment; Java version and pi4j version would helps.

Regards

kpolleck, 2017-03-01:
Thanks.  This seems like a coding / compling problem more than an environment problem.  It appears from http://pi4j.com/apidocs/com/pi4j/io/i2c/I2CFactory.html that I2CBus throws an "UnsupportedBusNumberException"...

**public static I2CBus getInstance(int busNumber)
                          throws I2CFactory.UnsupportedBusNumberException,
                                 IOException**

...and UnsuportedBuxNumber Exception extends Exception...

**public static class I2CFactory.UnsupportedBusNumberException
extends Exception**

...but neither UnsupportedBusNumberException nor Exception are thrown or passed to higher levels...

**public Board() throws IOException, InterruptedException**

Thus, this appears to be purely a compile-time problem between Board.java and I2CFactory.

Thread 227 (2017-05-03):

Streaming_Video_Example can't work

outan, 2017-05-03:
https://github.com/DexterInd/GoPiGo/tree/master/Software/Python/Examples/Streaming_Video_Example

```
$ cat stream_start.sh
#!/bin/bash

if [ ! -d /tmp/stream ]
then
    mkdir /tmp/stream/
fi

if pgrep raspistill > /dev/null
then
    echo "raspistill already running"
else
    raspistill -w 640 -h 480 -q 5 -o /tmp/stream/pic.jpg -tl 100 -t 9999999 -th 0:0:0 -n > /dev/null 2>&1&
    echo "raspistill started"
fi

if pgrep mjpg_streamer > /dev/null
then
    echo "mjpg_streamer already running"
  1 #!/bin/bash↲
else
    LD_LIBRARY_PATH=/opt/mjpg-streamer/ /opt/mjpg-streamer/mjpg_streamer -i "input_file.so -f /tmp/stream -n pic.jpg" -o "output_http.so -p 9000 -w /opt/mjpg-streamer/www" > /dev/null 2>&1&
    echo "mjpg_streamer started"

[pi@gopigo:~]$ lsal /opt/mjpg-streamer/mjpg_streamer
ls: cannot access /opt/mjpg-streamer/mjpg_streamer: No such file or directory

[pi@gopigo:~]$ lsal /opt/mjpg-streamer/
ls: cannot access /opt/mjpg-streamer/: No such file or directory

```

It seems that there's no mjpg-streamer installed in the gopigo.

$ sudo apt install mjpg_streamer
Reading package lists... Done
Building dependency tree
Reading state information... Done
E: Unable to locate package mjpg_streamer

outan, 2017-05-03:
I found this, and it can solve my problem.
https://miguelmota.com/blog/raspberry-pi-camera-board-video-streaming/

Closed 2022-03-07.

Thread 251 (2017-06-26):

Flask Server

hankp46, 2017-06-26:
When attempting to run flask server for Alexabot get following messages;
Have no idea on how to resolve

python alexabot-flask-app.py
 * Running on http://0.0.0.0:5000/
Traceback (most recent call last):
  File "alexabot-flask-app.py", line 73, in <module>
    app.run(debug=True, host='0.0.0.0')
  File "/usr/lib/python2.7/dist-packages/flask/app.py", line 772, in run
    run_simple(host, port, self, **options)
  File "/usr/lib/python2.7/dist-packages/werkzeug/serving.py", line 706, in run_simple
    test_socket.bind((hostname, port))
  File "/usr/lib/python2.7/socket.py", line 224, in meth
    return getattr(self._sock,name)(*args)
socket.error: [Errno 98] Address already in use

DexterInd, 2017-06-27:
Going to assume this was resolved, right?  :-)

hankp46, 2017-06-27:
N

hankp46, 2017-06-27:
Resolved socket error. But still can't get trigger to work. Posted full problem on Dexter forum under General Discussions. Any suggestions appreciated.

Closed 2022-03-07.
