DexterInd/GoPiGo/Hardware/GoPiGo_16_schematics.pdf

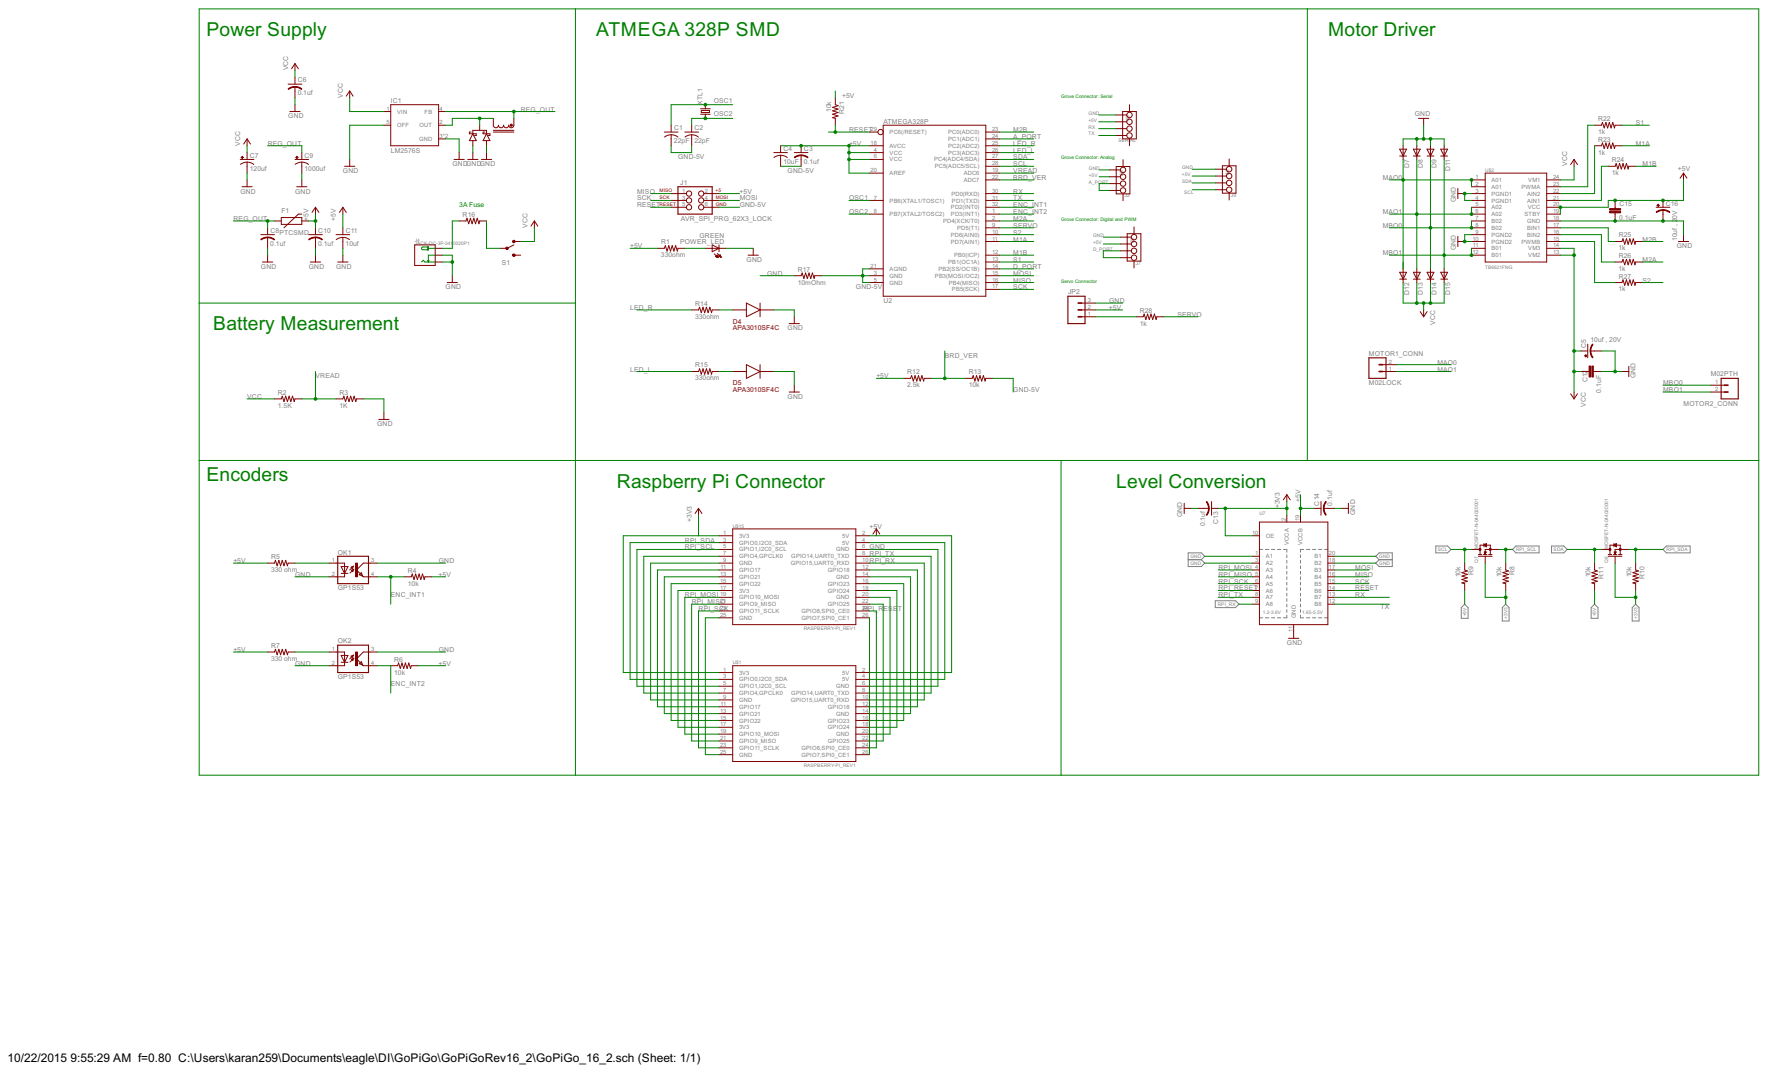
[picture p106: page 1]

Grove Connector: Digital and PWM

GND GND

10/22/2015 9:55:29 AM f=0.80 C:\Users\karan259\Documents\eagle\DI\GoPiGo\GoPiGoRev16_2\GoPiGo_16_2.sch (Sheet: 1/1)
