DexterInd/GoPiGo/Hardware/GoPiGo_Proto_10.sch

## EAGLE design Hardware/GoPiGo_Proto_10.sch (2014-04-14, last stored version)

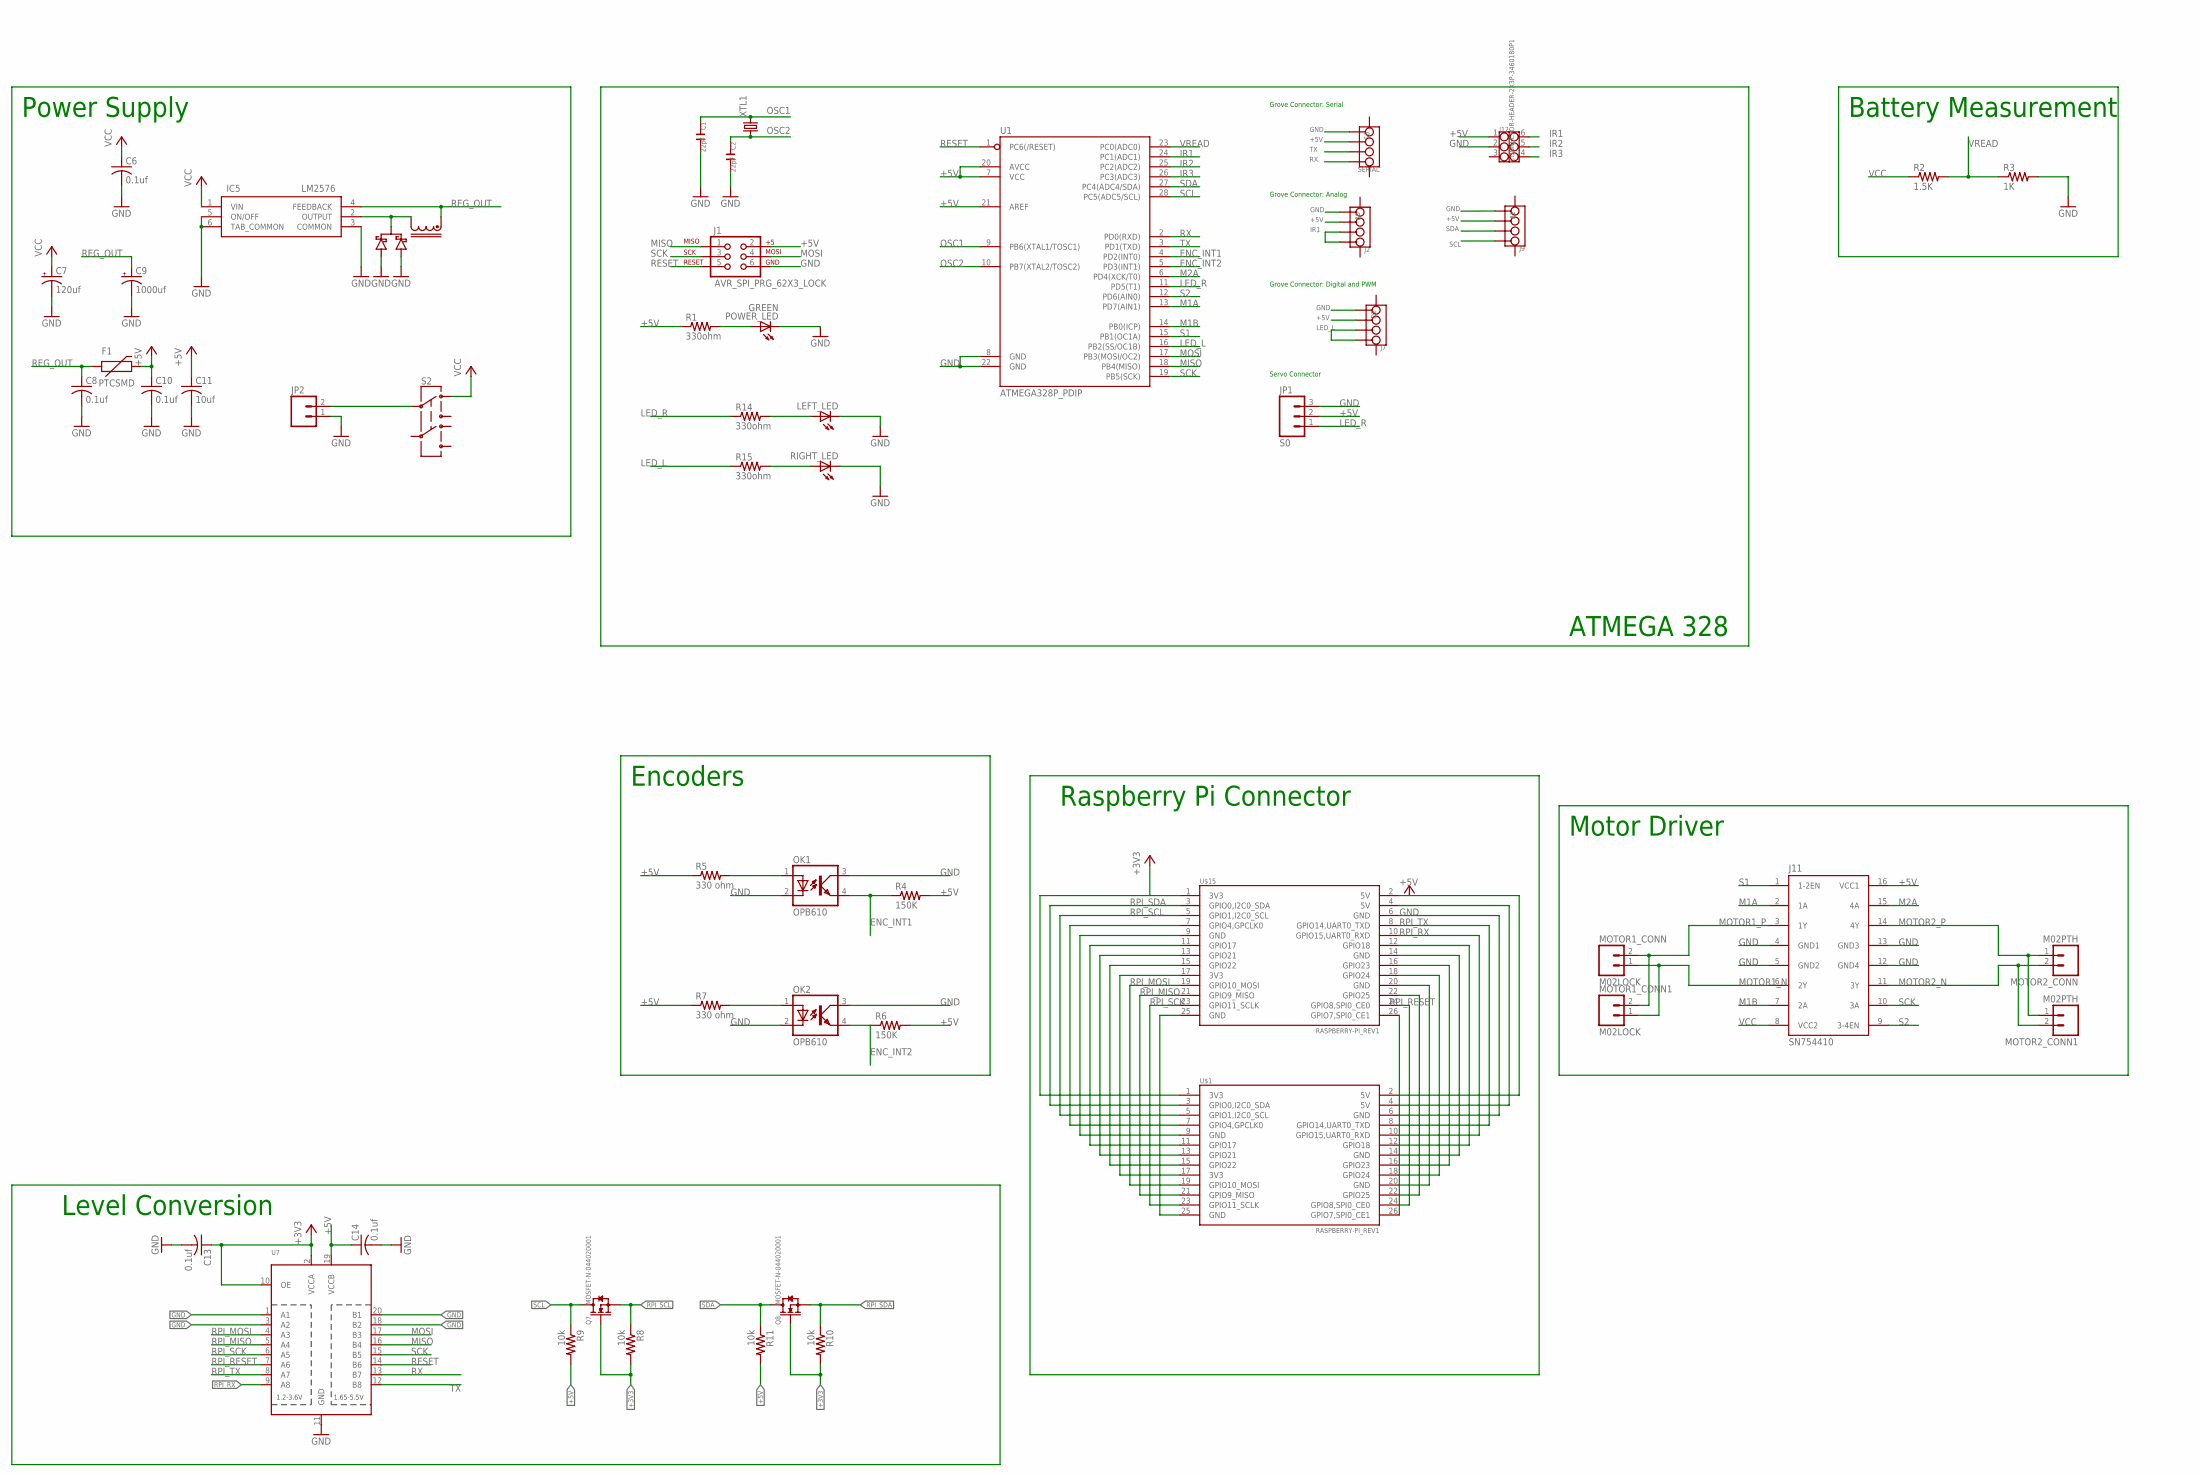
[picture p107: schematic GoPiGo_Proto_10.sch]

Parts:
C1, C2: 22pF; C0805
C6, C8, C10, C13, C14: 0.1uf; C0603
C7: 120uf; E2,5-6
C9: 1000uf; E5-13
C11: 10uf; C0805
D1: DIODE_SCHOTTKY_VS-6CWQ04FNTRPBF; DPAK
F1: PTCSMD; PTC-1206
IC5: LM2576; TO220-5-H
J1: AVR_SPI_PRG_62X3_LOCK; 2X3_LOCK
J2: A0; 4P-SMD-2.0-90D
J7: D2; 4P-SMD-2.0-90D
J9: A2; 4P-SMD-2.0-90D
J11: SN754410; DIL16
J12: CONNECTOR-HEADER-2X3P-3460180P1; 2X3P-2.54-2.54-11.6-3.0-BLACK-MALE
JP1: S0; 1X03
JP2: M02LOCK; 1X02_LOCK
LEFT_LED: LED5MM
MOTOR1_CONN, MOTOR1_CONN1: M02LOCK; 1X02_LOCK
MOTOR2_CONN, MOTOR2_CONN1: M02PTH; 1X02
OK1, OK2: OPB610; SFH9310
POWER_LED: GREEN; LED-0603
Q7, Q8: MOSFET-N-044020001; SOT23
R1, R14, R15: 330ohm; 0603-RES
R2: 1.5K; 0603-RES
R3: 1K; 0603-RES
R4, R6: 150K; 0603-RES
R5, R7: 330 ohm; 0603-RES
R8, R9, R10, R11: 10k; 0603-RES
RIGHT_LED: LED5MM
S2: SWITCH-DPDTOS; OS
SERIAL: S0; 4P-SMD-2.0-90D
U1: ATMEGA328P_PDIP; DIL28-3
U7: TXB0108PWR; TSSOP20
U$1, U$15: RASPBERRY-PI_REV1
U$14: INDUCTOR_PULSE_P0250.XXXNL
XTL1: CRYSTALHC49S; HC49/S

Connections:
+3V3: C13.1, Q7.1 (G), Q8.1 (G), R8.2, R10.2, U7.2 (VCCA), U7.10 (OE), U$1.1 (3V3), U$15.1 (3V3)
+5V: C10.1, C11.1, C14.1, F1.2, J1.2, J2.3, J7.3, J9.3, J11.16 (VCC1), J12.1, JP1.2, R1.1, R4.2, R5.1, R6.2, R7.1, R9.2, R11.2, SERIAL.3, U1.7 (VCC), U1.20 (AVCC), U1.21 (AREF), U7.19 (VCCB), U$1.2 (5V), U$15.2 (5V)
ENC_INT1: OK1.4 (EMIT), R4.1, U1.4 (PD2(INT0))
ENC_INT2: OK2.4 (EMIT), R6.1, U1.5 (PD3(INT1))
GND: C1.2, C2.2, C6.2, C7.-, C8.2, C9.-, C10.2, C11.2, C13.2, C14.2, D1.1, D1.3, IC5.3 (COMMON), IC5.5 (ON/OFF), IC5.6 (TAB_COMMON), J1.6, J2.4, J7.4, J9.4, J11.4 (GND1), J11.5 (GND2), J11.12 (GND4), J11.13 (GND3), J12.2, JP1.3, JP2.1, LEFT_LED.K (C), OK1.2 (C), OK1.3 (COL), OK2.2 (C), OK2.3 (COL), POWER_LED.C, R3.2, RIGHT_LED.K (C), SERIAL.4, U1.8 (GND), U1.22 (GND), U7.1 (A1), U7.3 (A2), U7.11 (GND), U7.18 (B2), U7.20 (B1), U$1.6 (GND), U$15.6 (GND)
IR1: J2.1, J2.2, J12.6, U1.24 (PC1(ADC1))
IR2: J12.5, U1.25 (PC2(ADC2))
IR3: J12.4, U1.26 (PC3(ADC3))
LED_L: J7.1, J7.2, R15.1, U1.16 (PB2(SS/OC1B))
LED_R: JP1.1, R14.1, U1.11 (PD5(T1))
M1A: J11.2 (1A), U1.13 (PD7(AIN1))
M1B: J11.7 (2A), U1.14 (PB0(ICP))
M2A: J11.15 (4A), U1.6 (PD4(XCK/T0))
MISO: J1.1, U1.18 (PB4(MISO)), U7.16 (B4)
MOSI: J1.4, U1.17 (PB3(MOSI/OC2)), U7.17 (B3)
MOTOR1_N: J11.6 (2Y), MOTOR1_CONN.1, MOTOR1_CONN1.1
MOTOR1_P: J11.3 (1Y), MOTOR1_CONN.2, MOTOR1_CONN1.2
MOTOR2_N: J11.11 (3Y), MOTOR2_CONN.2, MOTOR2_CONN1.2
MOTOR2_P: J11.14 (4Y), MOTOR2_CONN.1, MOTOR2_CONN1.1
unnamed: D1.4, IC5.2 (OUTPUT), U$14.P$2
unnamed: OK2.1 (A), R7.2
unnamed: OK1.1 (A), R5.2
unnamed: POWER_LED.A, R1.2
unnamed: LEFT_LED.A, R14.2
unnamed: R15.2, RIGHT_LED.A
unnamed: JP2.2, S2.2
unnamed: U$1.7 (GPIO4,GPCLK0), U$15.7 (GPIO4,GPCLK0)
unnamed: U$1.9 (GND), U$15.9 (GND)
unnamed: U$1.11 (GPIO17), U$15.11 (GPIO17)
unnamed: U$1.13 (GPIO21), U$15.13 (GPIO21)
unnamed: U$1.15 (GPIO22), U$15.15 (GPIO22)
unnamed: U$1.17 (3V3), U$15.17 (3V3)
unnamed: U$1.25 (GND), U$15.25 (GND)
unnamed: U$1.26 (GPIO7,SPI0_CE1), U$15.26 (GPIO7,SPI0_CE1)
unnamed: U$1.22 (GPIO25), U$15.22 (GPIO25)
unnamed: U$1.20 (GND), U$15.20 (GND)
unnamed: U$1.18 (GPIO24), U$15.18 (GPIO24)
unnamed: U$1.16 (GPIO23), U$15.16 (GPIO23)
unnamed: U$1.14 (GND), U$15.14 (GND)
unnamed: U$1.12 (GPIO18), U$15.12 (GPIO18)
unnamed: U$1.4 (5V), U$15.4 (5V)
OSC1: C1.1, U1.9 (PB6(XTAL1/TOSC1)), XTL1.2
OSC2: C2.1, U1.10 (PB7(XTAL2/TOSC2)), XTL1.1
REG_OUT: C8.1, C9.+, F1.1, IC5.4 (FEEDBACK), U$14.P$1
RESET: J1.5, U1.1 (PC6(/RESET)), U7.14 (B6)
RPI_MISO: U7.5 (A4), U$1.21 (GPIO9_MISO), U$15.21 (GPIO9_MISO)
RPI_MOSI: U7.4 (A3), U$1.19 (GPIO10_MOSI), U$15.19 (GPIO10_MOSI)
RPI_RESET: U7.7 (A6), U$1.24 (GPIO8,SPI0_CE0), U$15.24 (GPIO8,SPI0_CE0)
RPI_RX: U7.9 (A8), U$1.10 (GPIO15,UART0_RXD), U$15.10 (GPIO15,UART0_RXD)
RPI_SCK: U7.6 (A5), U$1.23 (GPIO11_SCLK), U$15.23 (GPIO11_SCLK)
RPI_SCL: Q7.2 (S), R8.1, U$1.5 (GPIO1,I2C0_SCL), U$15.5 (GPIO1,I2C0_SCL)
RPI_SDA: Q8.2 (S), R10.1, U$1.3 (GPIO0,I2C0_SDA), U$15.3 (GPIO0,I2C0_SDA)
RPI_TX: U7.8 (A7), U$1.8 (GPIO14,UART0_TXD), U$15.8 (GPIO14,UART0_TXD)
RX: SERIAL.1, U1.2 (PD0(RXD)), U7.13 (B7)
S1: J11.1 (1-2EN), U1.15 (PB1(OC1A))
S2: J11.9 (3-4EN), U1.12 (PD6(AIN0))
SCK: J1.3, J11.10 (3A), U1.19 (PB5(SCK)), U7.15 (B5)
SCL: J9.1, Q7.3 (D), R9.1, U1.28 (PC5(ADC5/SCL))
SDA: J9.2, Q8.3 (D), R11.1, U1.27 (PC4(ADC4/SDA))
TX: SERIAL.2, U1.3 (PD1(TXD)), U7.12 (B8)
VCC: C6.1, C7.+, IC5.1 (VIN), J11.8 (VCC2), R2.1, S2.1
VREAD: R2.2, R3.1, U1.23 (PC0(ADC0))

Notes on the sheet:
Encoders
Power Supply
Battery Measurement
Motor Driver
Raspberry Pi Connector
Grove Connector: Serial
Grove Connector: Analog
Grove Connector: Digital and PWM
Servo Connector
ATMEGA 328
Level Conversion
