DexterInd/GoPiGo/Software/C/gopigo.c

// ####################################################################################
// This library is used for communicating with the GoPiGo.
// http://www.dexterindustries.com/GoPiGo/
// History
// ------------------------------------------------
// Date               Comments
// 30 Aug 15          Initial Authoring
// 02 Feb 16          Support Encoders

// ## License
//
// GoPiGo for the Raspberry Pi: an open source robotics platform for the Raspberry Pi.
// Copyright (C) 2017  Dexter Industries

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
// ####################################################################################
#include "gopigo.h"

#define WRITE_BUF_SIZE 5
#define READ_BUF_SIZE 32

int fd;
const char *fileName = "/dev/i2c-1";
const int address = 0x08;
unsigned char w_buf[WRITE_BUF_SIZE],r_buf[READ_BUF_SIZE];
const unsigned long reg_addr=0;
int version=200;    //Initialized with invalid version
const int v16_thresh=790;

int init(void)
{
    int i,raw;
    if ((fd = open(fileName, O_RDWR)) < 0)
    {
        // Open port for reading and writing
        printf("Failed to open i2c port\n");
        return -1;
    }

    if (ioctl(fd, I2C_SLAVE, address) < 0)
    {
        // Set the port options and set the address of the device
        printf("Unable to get bus access to talk to slave\n");
        return -1;
    }
    for(i=0;i<10;i++)
        raw=analogRead(7);
    if(raw>v16_thresh)
        version=16;
    else
        version=14;
    return 1;
}
//Write a register
int write_block(char cmd,char v1,char v2,char v3)
{
    w_buf[0]=1;
    w_buf[1]=cmd;
    w_buf[2]=v1;
    w_buf[3]=v2;
    w_buf[4]=v3;

    ssize_t ret = write(fd, w_buf, WRITE_BUF_SIZE);

    // sleep for 1 ms to prevent too fast writing
    pi_sleep(1);

    if (ret != WRITE_BUF_SIZE) {
        if (ret == -1) {
            printf("Error writing to GoPiGo (errno %i): %s\n", errno, strerror(errno));
        }
        else {
            printf("Error writing to GoPiGo\n");
        }
        return ret;
    }
    return 1;
}

//Read 1 byte of data
char read_byte(void)
{
    int reg_size=1;

    ssize_t ret = read(fd, r_buf, reg_size);

    if (ret != reg_size) {
        if (ret == -1) {
            printf("Unable to read from GoPiGo (errno %i): %s\n", errno, strerror(errno));
        }
        else {
            printf("Unable to read from GoPiGo\n");
        }
        return -1;
    }

    return r_buf[0];
}

float volt(void)
{
    int v[2];
    float voltage;
    write_block(volt_cmd,0,0,0);
    pi_sleep(100);
    v[0]=read_byte();
    v[1]=read_byte();
    voltage=v[0]*256+v[1];
    voltage=(5.0*voltage/1024)/.4;
    return voltage;
}

int fwd()
{
    return write_block(fwd_cmd,0,0,0);
}
int stop()
{
    return write_block(stop_cmd,0,0,0);
}

void pi_sleep(int t)
{
    usleep(t*1000);
}

//Control Motor 1
int motor1(int direction,int speed)
{
    return write_block(m1_cmd,direction,speed,0);
}

//Control Motor 2
int motor2(int direction,int speed)
{
    return write_block(m2_cmd,direction,speed,0);
}

//Move the GoPiGo forward without PID
int motor_fwd(void)
{
    return write_block(motor_fwd_cmd,0,0,0);
}
//Move GoPiGo back
int bwd(void)
{
    return write_block(motor_bwd_cmd,0,0,0);
}

//Move GoPiGo back without PID control
int motor_bwd(void)
{
    return write_block(motor_bwd_cmd,0,0,0);
}

//Turn GoPiGo Left slow (one motor off, better control)
int left(void)
{
    return write_block(left_cmd,0,0,0);
}

//Rotate GoPiGo left in same position (both motors moving in the opposite direction)
int left_rot(void)
{
    return write_block(left_rot_cmd,0,0,0);
}

//Turn GoPiGo right slow (one motor off, better control)
int right(void)
{
    return write_block(right_cmd,0,0,0);
}

//Rotate GoPiGo right in same position both motors moving in the opposite direction)
int right_rot(void)
{
    return write_block(right_rot_cmd,0,0,0);
}

//Increase the speed
int increase_speed(void)
{
    return write_block(ispd_cmd,0,0,0);
}

//Decrease the speed
int decrease_speed(void)
{
    return write_block(dspd_cmd,0,0,0);
}

//Trim test with the value specified
int trim_test(int value)
{
    if (value>100)
        value=100;
    else if(value<-100)
        value=-100;
    value+=100;
    return write_block(trim_test_cmd,value,0,0);
}

//Read the trim value in EEPROM if present else return -3
int trim_read(void)
{
    int b1,b2,trim;
    if(write_block(trim_read_cmd,0,0,0)==-1)
        return -1;
    pi_sleep(80);
    b1=read_byte();
    b2=read_byte();
    if(b1==-1 || b2==-1)
        return -1;
    trim=b1*256+b1;
    if (trim ==255)
        return -3;
    return trim;
}

//Write the trim value to EEPROM, where -100=0 and 100=200
int trim_write(int value)
{
    if (value>100)
        value=100;
    else if(value<-100)
        value=-100;
    value+=100;
    return write_block(trim_write_cmd,value,0,0);
}

// Arduino Digital Read
int digitalRead(int pin)
{
    int dRead;
    if(pin==10||pin==15||pin==0||pin==1)
    {
        if(write_block(digital_read_cmd,pin,0,0)==-1)
            return -1;
        pi_sleep(100);
        dRead=read_byte();
        read_byte();
        if(dRead==-1)
            return -1;
        return dRead;
    }
    else
        return -2;
}
// Arduino Digital Write
int digitalWrite(int pin, int value)
{
    if(value==0 || value==1)
        return write_block(digital_write_cmd,pin,value,0);
    else
        return -2;
}

// Setting Up Pin mode on Arduino
int pinMode(int pin, char * mode)
{
    if(strcmp(mode,"ÏNPUT")==0)
        return write_block(pin_mode_cmd,pin,0,0);
    else if(strcmp(mode,"OUTPUT")==0)
        return write_block(pin_mode_cmd,pin,1,0);
    return -1;
}

// Read analog value from Pin
int analogRead(int pin)
{
    int b1,b2;
    write_block(analog_read_cmd,pin,0,0);
    pi_sleep(70);
    b1=read_byte();
    b2=read_byte();
    if(b1==-1 || b2==-1)
        return -1;
    return b1* 256 + b2;
}

// Write PWM
int analogWrite(int pin, int value)
{
    if(pin==10)
    {
        return write_block(analog_write_cmd,pin,value,0);
    }
    return -2;
}

//Read board hardware revision
int brd_rev(void)
{
    return version;
}
//Read ultrasonic sensor
//    arg:
//        pin ->     Pin number on which the US sensor is connected
//    return:        distance in cm
int us_dist(int pin)
{
    int b1,b2;
    write_block(us_cmd,pin,0,0);
    pi_sleep(80);
    b1=read_byte();
    b2=read_byte();
    if(b1==-1 || b2==-1)
        return -1;
    return b1* 256 + b2;
}

//Read motor speed (0-255)
//    arg:
//        speed -> pointer to array of 2 bytes [motor1, motor2], allocated before
void read_motor_speed(unsigned char* speed)
{
    write_block(read_motor_speed_cmd,0,0,0);
    pi_sleep(1);
    speed[0]=read_byte();
    speed[1]=read_byte();
    return;
}

//Turn led on or off
//    arg:
//        l_id: 1 for left LED and 0 for right LED
//        onoff: 0 off, 1 on
int led_toggle(int l_id, bool onoff)
{
    int r_led,l_led;
    if (version>14)
    {
        r_led=16;
        l_led=17;
    }
    else
    {
        r_led=5;
        l_led=10;
    }

    // set led pin
    int led_pin;
    if (l_id==LED_L)
        led_pin = l_led;
    else if (l_id==LED_R)
        led_pin = r_led;
    else
        return -1;

    // write
    pinMode(led_pin,"OUTPUT");
    int ret = digitalWrite(led_pin, onoff);

    if (ret<=0)
        return -1;
    else
        return 1;
}
//Turn led on
//    arg:
//        l_id: 1 for left LED and 0 for right LED
int led_on(int l_id)
{
    return led_toggle(l_id, 1);
}
//Turn led off
//    arg:
//        l_id: 1 for left LED and 0 for right LED
int led_off(int l_id)
{
    return led_toggle(l_id, 0);
}
//Set servo position
//    arg:
//        position: angle in degrees to set the servo at
int servo(int position)
{
    return write_block(servo_cmd,position,0,0);
}

//Returns the firmware version
int fw_ver(void)
{
    int ver;
    write_block(fw_ver_cmd,0,0,0);
    pi_sleep(100);
    ver=read_byte();
    read_byte();
    if(ver==-1)
        return -1;
    return ver;
}
//Set speed of the left motor
//    arg:
//        speed-> 0-255
int set_left_speed(int speed)
{
    if(speed >255)
        speed =255;
    else if(speed <0)
        speed =0;
    return write_block(set_left_speed_cmd,speed,0,0);
}
//Set speed of the right motor
//    arg:
//        speed-> 0-255
int set_right_speed(int speed)
{
    if(speed >255)
        speed =255;
    else if(speed <0)
        speed =0;
    return write_block(set_right_speed_cmd,speed,0,0);
}
//Set speed of the both motors
//    arg:
//        speed-> 0-255
int set_speed(int speed)
{
    if(speed >255)
        speed =255;
    else if(speed <0)
        speed =0;
    set_left_speed(speed);
    pi_sleep(100);
    set_right_speed(speed);
    return 1;
}

int enc_read(int motor)
{
    write_block(enc_read_cmd, motor, 0, 0);
    pi_sleep(80);
    int b1 = read_byte();
    int b2 = read_byte();

    if (b1!=-1 && b2!=-1)
        return b1*256 + b2;
    else
        return -1;
}

// Enable the encoders (enabled by default)
int enable_encoders(void)
{
    return write_block(en_enc_cmd, 0,0,0);
}

// Disable the encoders (use this if you don't want to use the encoders)
int disable_encoders(void)
{
    return write_block(dis_enc_cmd,0,0,0);
}

//Set encoder targeting on
//arg:
//    m1: 0 to disable targeting for m1, 1 to enable it
//    m2:    1 to disable targeting for m2, 1 to enable it
//    target: number of encoder pulses to target (18 per revolution)
int enc_tgt(int m1, int m2, int target)
{
    if( m1>1 || m1<0 || m2>1 || m2<0 )
        return -1;
    int m_sel = m1*2+m2;
    write_block(enc_tgt_cmd, m_sel, target/256, target%256);
    return 1;
}

//Read encoder status
//    return:    0 if encoder target is reached
int read_enc_status(void)
{
    int st=read_byte();
    read_byte();
    return st;
}

//Read timeout status
//    return:    0 if timeout is reached
int read_timeout_status(void)
{
    read_byte();
    int st=read_byte();
    return st;
}
