DexterInd/GoPiGo/Firmware/servo_test/servo_test.ino

// Sweep
// by BARRAGAN <http://barraganstudio.com> 
// This example code is in the public domain.


#include <Servo.h> 
 
Servo myservo,m1;  // create servo object to control a servo 
                // a maximum of eight servo objects can be created 
 
int pos = 0;    // variable to store the servo position 
 
void setup() 
{ 
  myservo.attach(5);  // attaches the servo on pin 9 to the servo object 
  m1.attach(11); 
} 
 
 
void loop() 
{ 
  for(pos = 0; pos < 180; pos += 1)  // goes from 0 degrees to 180 degrees 
  {                                  // in steps of 1 degree 
    myservo.write(pos);              // tell servo to go to position in variable 'pos' 
    m1.write(pos);
    delay(10);                       // waits 15ms for the servo to reach the position 
  } 
  for(pos = 180; pos>=1; pos-=1)     // goes from 180 degrees to 0 degrees 
  {                                
    myservo.write(pos);              // tell servo to go to position in variable 'pos' 
    m1.write(pos);
    delay(10);                       // waits 15ms for the servo to reach the position 
  } 
} 
