DexterInd/GoPiGo/Software/Python/other_scripts/motortest.py

import smbus
import time

# for RPI version 1, use "bus = smbus.SMBus(0)"
bus = smbus.SMBus(1)

# This is the address we setup in the Arduino Program
address = 0x04

def writeNumber(value):
    bus.write_byte(address, value)
    # bus.write_byte_data(address, 0, value) 
    return -1

def readNumber():
    number = bus.read_byte(address)
    # number = bus.read_byte_data(address, 1)
    return number

time.sleep(1)
i=0
while True:
	a=raw_input()
	try:
		print ord(a)
		writeNumber(ord(a))
	except TypeError:
		print "Invalid Input"
	time.sleep(.1)
	
	
	
