DexterInd/GoPiGo/Software/Python/basic_test_all.py

#!/usr/bin/env python
from __future__ import print_function
from __future__ import division
from builtins import input

'''
## License
 GoPiGo for the Raspberry Pi: an open source robotics platform for the Raspberry Pi.
 Copyright (C) 2017  Dexter Industries

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
You should have received a copy of the GNU General Public License
along with this program.  If not, see <http://www.gnu.org/licenses/gpl-3.0.txt>.
'''

from gopigo import *
import sys

import atexit
atexit.register(stop)

def print_menu():
	print( "  w	:	Move the GoPiGo forward")
	print( "  a	:	Turn the GoPiGo left")
	print( "  s	:	Move the GoPiGo back")
	print( "  d	:	Turn the GoPiGo right")
	print( "  n	:	Rotate the GoPiGo left in place")
	print( "  m	:	Rotate the GoPiGo right in place")
	print( "  x	:	Stop the GoPiGo")
	print( "  t	:	Increase the speed by 10 (default 200, min:0 max 255)")
	print( "  g	:	Reduce the speed by 10")
	print( "  v	:	Print the voltage of the batteries (should be greater than 10)")
	print( "  st	:	Set servo position")
	print( "  b	:	Run a servo 180 degree sweep")
	print( "  u	:	Get the distance from the ultrasonic ranger")
	print( "  l	:	Turn the LED's on and off")
	print( "  f	:	Print the firmware version on the GoPiGo")
	print( "  tr	:	Read the trim value on the GoPiGo")
	print( "  tw	:	Write the trim value to the GoPiGo")
	print( "  tt	:	Test the trim value to the GoPiGo")
	print( "  ?	:	Print the menu again")
	print( "  z	:	Exit")
	print( "Please type a command and press ENTER: ")
	
print( "  ____       ____  _  ____       ")
print( " / ___| ___ |  _ \(_)/ ___| ___  ")
print( "| |  _ / _ \| |_) | | |  _ / _ \ ")
print( "| |_| | (_) |  __/| | |_| | (_) |")
print( " \____|\___/|_|   |_|\____|\___/ ")
print( "")
print( "Welcome to GoPiGo Basic test program\nYou can use this to try out the various features of your GoPiGo\n")
print_menu()
while True:
	print( "\nCmd:",end="")
	a=input()
	if a=='w':
		fwd()
	elif a=='a':
		left()
	elif a=='d':
		right()
	elif a=='s':
		bwd()
	elif a=='x':
		stop()
	elif a=='t':
		increase_speed()
	elif a=='g':
		decrease_speed()
	elif a=='v':
		print( "{}V".format(volt()))
	elif a=='b': #servo test
		for i in range(180):
			servo(i)
			print( i)
			time.sleep(.02)
	elif a=='z':
		sys.exit()
	elif a=='u':
		print( '{}cm'.format(us_dist(15)))
	elif a=='l':
		led_on(0)
		led_on(1)
		time.sleep(1)
		led_off(0)
		led_off(1)
	elif a=='i':
		motor_fwd()
	elif a=='k':
		motor_bwd()
	elif a=='n':
		left_rot()
	elif a=='m':
		right_rot()
	elif a=='y':
		enc_tgt(1,1,18)
	elif a=='f':
		print( "v{}".format(fw_ver()))
	elif a=='tr':
		val=trim_read()
		if val==-3:
			print( "-3, Trim Value Not set")
		else:
			print( val-100)
	elif a=='tw':
		print( "Enter trim value to write to EEPROM(-100 to 100):",end="")
		val=int(input())
		trim_write(val)
		time.sleep(.1)
		print( "Value in EEPROM: {}".format(trim_read()-100))
	elif a=='tt':
		print( "Enter trim value to test(-100 to 100):",end="")
		val=int(input())
		trim_test(val)
		time.sleep(.1)
		print( "Value in EEPROM: {}".format(trim_read()-100))
	elif a=='st':
		print( "Enter Servo position:",end="")
		val=int(input())
		servo(val)
	elif a=='?':
		print_menu()
	time.sleep(.1)
