DexterInd/GoPiGo/Software/Python/other_scripts/tts.py

import sys
import pyttsx
 
# main() function
def main():
  # use sys.argv if needed 
  print 'running speech-test.py...'
  engine = pyttsx.init()
  str = "I speak. Therefore. I am.  "
  engine.say(str)
  engine.runAndWait() 

 
# call main
if __name__ == '__main__':
  main()
