DexterInd/GoPiGo/(commit log)

2013-10-29 PCB testing firmware's added
2014-03-04 Basic encoder test
    Rotate the wheels with hand to make the LED's blink
2014-03-26 Integrated library added
    - PID motor control
    - Voltage display
    - Servo control
    - us sensor control
2014-06-05 Motors and voltage working i2c
2014-06-05 LED and US working(1port)
2014-06-10 motor functions tested
2014-06-10 Encoder targetting working(I2C crash)
    [basic_test_all.py, gopigo.py, robot_integ_i2c.ino]
2014-06-13 Library and firmware checked, examples added
    [gps_data.csv]
2014-06-13 Documentation added to firmware and library
    [GoPiGo_Proto_10.sch, gps_data.csv]
2014-07-02 Minor feature addition and mug removal
    -Naming of variables
    -F/w versioning
    -motor speed set
    -PID correction
    -enable/disable servo,encoder
    [basic_test_all.py, gopigo.py, robot_integ_i2c.ino]
2014-07-02 Revert "Minor feature addition and mug removal"
    This reverts commit f54aa985dc25df3422890b5d4a8c163217475d4c.
    [basic_test_all.py, gopigo.py, robot_integ_i2c.ino]
2014-07-02 Minor Feature addition and bug removal
    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
    [basic_test_all.py, gopigo.py, robot_integ_i2c.ino]
2014-07-07 Motor timeout added
2014-07-08 Motor communication timeout added
2014-07-30 I2C revision for Model B+ added
2014-08-22 basic servo example added
2014-08-22 Basic servo touchup.
    Touched up the basic servo example
2014-08-25 Basic ultrasonic example added
2014-08-25 Python example readme update and name changes
    [gps_data.csv]
2014-08-25 example files reorganized
    [gps_data.csv]
2014-08-25 Office cannon Raspberry Pi model B+ support added
2014-08-26 Explanation B+ pin
2014-09-08 V1.0 Firmware update
    - Bug removed for motors randomly stopping
    - Code cleaned up
    - Status flags and timeout's tested
2014-09-10 Firmware version and voltage in bash script
2014-09-26 Update with ultrasonic.
2014-09-26 Update firmware update script
    Updated firmware_update.sh:
    - Add a disconnected motors check.
    - Updated fuses.
    - Added a sudo check.
2014-09-26 Servo Jitters removed ands serial baud changed
2014-11-13 Stop the motors on basic_test_all.py exit
    For safety.
2015-01-22 Switch back to no PID in SOftware
2015-02-09 Firmware and software update added (Basic functions and independent motor control)
2015-02-09 LED blink example added
2015-02-19 Parameter to enable I2C on Kernel 3.18 added
2015-03-16 GPG firmware & software updates
    - Scratch LED's working
    - Problem with install script removed
    - Firmware v13 added
    -> Read encoder values
    -> Test and use trim
    -> Servo Jitters removed
    [basic_test_all.py, enc_val_read.py]
2015-03-16 Encoder read example updated
2015-03-27 Trim and encoder reading function added
2015-04-06 Hardware test to check the motors added
2015-05-12 Added servo() cmd to Scratch python bridge.
2015-05-16 Added function to determine number of encoder pulses per cm of travel.
2015-05-21 Fixed version command, Removed Encoder
    Fixed version.
    Removed encoder from interface for now. Not working for some reason.
    Looking into it
2015-06-01 Added light sensor.
    Added light esnsor code.
2015-06-04 Scratch sensors added for the GoPiGo
    Button, Light, Sound, Ultrasonic distance, Buzzer, LED, Motion, IR
    receiver, DI line sensor
2015-06-17 Added IR Receiver sensor + tweaks
2015-06-28 Fixed bug in Led constructor, changed logDir configuration, generated new javadoc
    [Led.java]
2015-07-15 Scratch: Updated sound sensor for
2015-07-20 Update Scratch Sensor Port Documentation
2015-07-22 Line sensor functions added
2015-07-29 Firmware v15 added
    - Much more robust with less packet drops
    - Read motor speed functions added
    - IR receiver disabled
2015-07-29 Python library updated and test for encoder targeting added
2015-08-18 Firmware v16 added
    Minor changes to increase stability of the firmware
    [SoftwareServo.cpp, fw_ver_16.ino]
2015-08-27 Raspberry Pi camera support added
2015-08-27 Variable renamed for camera support in scratch
2015-08-27 Picture for using the camera added to the Readme
2015-08-31 Created skeleton script to try to navigate through a hole.
2015-08-31 Finished Find Hole python example.
2015-08-31 AFixed bugs and added debugging prints.
2015-09-02 fixed various compiling erors and wrote test file
    [basic_test_all.c, gopigo.c, gopigo.h]
2015-09-02 fixed the issue. it was sleeping using sleep function imported from unistd library
    [gopigo.c]
2015-10-20 Script updated to make scratch executable and I2C non sudo
2015-10-22 Latest hardware schematics added
    [GoPiGo_Proto_10.sch]
2015-10-27 Update README.md
    Update the Find Hole Readme to something readable.
2015-11-04 Line sensor init files added
2015-11-05 Ultrasonic demo
    GoPiGo will look all around and point in the direction of the closest
    object.
    Ultrasonic sensor on port A1
2015-11-18 Print devices on USB in the troubleshooting script
2015-12-14 Line sensor check and basic examples added
2015-12-14 example to get absolute values from the line sensor
2016-01-04 Grove port LED blink example added
2016-01-19 Line sensor scratch integration and GUI added
2016-02-02 support reading encoder values from motors
2016-02-11 Line sensor example added to scratch example
2016-02-16 Improved Line Sensor GUI
2016-02-16 Add line_follower calibration shortcut
2016-02-17 write correct value in digitalWrite
    [gopigo.c]
2016-02-17 typo fixed for LED on/off
    [basic_test_all.c]
2016-03-09 detailed error evaluation for read/write
    Print a description of read/write errors according to errno. Forward return
    value from read/write syscalls for further failure handling.
    [gopigo.c, gopigo.h]
2016-03-09 refactoring of led_on/led_off to share common code
    There is now a common led_toggle function that provides the writing to the
    LED ports and which is used by led_on/led_off for de-/activating the LEDs.
2016-03-09 sleep 1ms to prevent too fast writing
    [gopigo.c]
2016-03-10 fix writing to selected LED pin 'led_pin' instead of left LED
    [gopigo.c]
2016-03-12 google is blocked in China, use raspberrypi.org instead
    Peaple can't visit google.com in China, try to use raspberrypi.org to check connection instead.
2016-03-12 do not shut down on read error, this causes unexpected behaviour of robot
    [gopigo.c]
2016-03-12 read motor speed (0-255), values given as call-by-reference
2016-04-04 Grove sensor examples for the GoPiGo added
2016-04-04 Prints error message instead of crashing in scratch
2016-05-09 Converted Solution and Project from VS 2015 RC
    Updated solution and project files to VS 2015 Update 2
    Added simple code to Driver app to make the GoPiGo do something
2016-05-20 Update GoPiGoScratch.py
    some debug info into the sound sensor handling
2016-05-27 Bump i2c-bus
2016-06-03 IR sensor scratch code updated
2016-06-07 DHT sensor example added
2016-06-09 Example script for individual motor control added
2016-06-15 Support for blue DHT sensor in Scratch
2016-06-15 don't poll the DHT sensor more than once every two seconds
2016-06-15 DHT Sensor: fix a delay bug in example
2016-08-29 add regular expressions to support GET_DIST, GET DISTANCE for ultrasonic sensor
2016-08-30 Use Regex for ultrasonic sensor: GET_DIST as the original GET DISTANCE as documented in the scratch card handout also GET DIST and GET_DISTANCE for orthogonality
2016-09-08 some cleanup in Sound sensor code
2016-09-10 sound sensor cleanup
2016-09-10 don't use path as a variable. Switched to dir_path
2016-09-14 added error messages if IR sensor is not properly enabled and user attempts to read it
2016-09-14 Error msg if IR receiver is not enabled
    This prints out error messages to the terminal window in the background. It's an improvement over crashing, but still not 100% user friendly. It would be so nice if we could send back error messages to Scratch.
2016-09-28 try/except to avoid dying when casting into an int
    [gopigo.py]
2016-09-29 Change of spacing between the buttons
    Changed the Window frame size and the spacing of the buttons
2016-10-05 Remove stray print statements
    Comment out forgotten print statements
2016-10-11 Centering line sensor information.
    Line sensor output data is centered.
2016-10-17 add FOLDER to set folder where to save photos change userid on photos so users can erase (remove extraneous print statement)
2016-10-18 Temperature Sensor example
2016-10-20 DHT Sensor: send sensorvalue even on error to allow users to program even if the DHT is not currently plugged in
2016-10-25 fix uppercase print statement
    [basic_test_all.py]
2016-11-01 Add a comment for Python3
    # the above lines are meant for Python3 compatibility.
    # they force the use of Python3 functionality for print(),
    # the integer division and input()
    # mind your parentheses!
2016-11-01 Added comments about Python3
    # they force the use of Python3 functionality for print()
    # and the integer division
    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
2016-11-09 Update Grove Button Example
    Changed the button location.
2016-12-15 servo port was badly labelled
2016-12-22 Add wiringPi Installation test
    This should test if WiringPi is installed, and if it is, skip the
    install. If it isn't, install it in ~/Dexter/Github
2017-01-04 move handling of wiringPi to Raspbian_For_Robots and use wget to get it from here
2017-01-06 install script_tools. call wiringpi setup in script_tools
2017-01-06 call the wiringpi script that's already on the SD card
2017-03-03 Make ultrasonic sensor a bit more stable
2017-03-22 changes to the buzzer class: cannot set the buzzer to a negative power. keep track of current buzzer power level
    [easygopigo.py]
2017-03-23 Introduce a linear correction for the ultrasonic sensor
    [easygopigo.py, gopigo.py]
2017-04-02 Attempt at making easygopigo thread_safe (#218)
    First, before each read, wait till the bus is available
    Second, confirm the bus is open before doing the read (in case another thread got it)
    Third, grab the read flag
    Fourth do the read
    Fifth, release the read flag asap for other threads
    This only works for one process and only if all readings go through easygopigo
    More than one process would still experience issues, but a single multi threaded process would be safe.
    [easygopigo.py]
2017-04-07 Changes to support firmware update from di update
2017-05-10 Ultrasonic sensor: remember port information, and reduce distance to 3m
2017-05-11 Fix Analog.percent_read() and remove extra print statement
    [easygopigo.py, gopigo.py]
2017-05-11 Add SERVO as a supported port
2017-05-15 use Mutex to avoid conflicts when accessing the GoPiGo
    [easygopigo.py]
2017-05-22 support distance sensor on easygopigo
2017-05-23 distance sensor needs process/thread protection around its instantiation
2017-05-23 Go overboard with try/except where mutex is required Experience has shown that if something goes wrong while the lock is acquired then the whole web server is stuck. With try/except, we ensure that t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
    [easygopigo.py]
2017-05-23 just ignore the exception in _grab_read() should the mutex_Acquire() fail. Which isn't meant to happen. Ever. Famous last words...
    [easygopigo.py]
2017-05-29 create an EasyGoPiGo class that takes care of thread-safe protection.
2017-05-31 remove some print statements
2017-06-01 Put all Distance Sensor code inside try/except Easygopigo is currently available but not the distance sensor code yet. Also put a bunch of other try/except around mutex and gopigo access.
2017-06-01 Print warning message. Have to rethink what to do if a try fails. Right now the except is a simple pass. Would it be better to raise an exception or print a msg? I have to think this through
    [easygopigo.py]
2017-06-05 better error handling. Well, sort of. At least we print error messages now
    [easygopigo.py, gopigo.py]
2017-06-06 adding a small delay in Ultrasonic Sensor Read function seems to help with conflicts
2017-06-14 Easygopigo : some exception handling
    line follower: avoid an infinite loop
    scratch_line: better error handling when line follower is not answering
    [easygopigo.py]
2017-06-17 Upgrade Adafruit DHT library to latest version which detects Raspberry Pi 3
2017-06-20 Missing Slash in Line Reader
    Missing slash causing errors reading the line sensor. The path was incorrect and failing.
2017-06-23 ref #3 : tweaked the filtering process
2017-07-11 Update distance sensor import
2017-07-19 add a is_button_pressed method to the ButtonSensor class
2017-07-20 Bring Distance Sensor in line with new API
2017-07-21 Install line follower properly
    Servo support in easygopigo
2017-08-07 add a DEFAULT_SPEED "constant" and a reset_speed method
    [easygopigo.py]
2017-08-11 ir_receiver.py > fix bug that occured when user presses the same key twice
    easygopigo.py >
    change the way we handle the non activation of the IR server.
    [easygopigo.py]
2017-08-21 Added Loudness sensor and DHT sensor
2017-08-31 Limit percent_read to 100%. We want to avoid classroom contests with the loudness sensor and the sound sensor
    [easygopigo.py]
2017-10-02 Add Documentation
    Adding assembly and setup documentation to GoPIGo.
2017-10-10 feature - assembly instructions for the GoPiGo2 (#274)
    feature - assembly instructions for the GoPiGo2
2017-10-10 feature - assembly instructions for the GoPiGo2 (#274) (#275)
    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
2017-10-19 Line follower (#276)
    * Attempt at making easygopigo thread_safe
    * Install line follower in a standard way.
    To import use:
    from line_follower import line_sensor
    and it works!
    * get rid of double self. One ego is enough
    * Some phantom lines had reappeare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
    [easygopigo.py]
2017-10-23 object-oriented [I2C_mutex] module (#263)
    * ref RobertLucian/GoPiGo#6 : feature - adding object-oriented I2C_mutex
    * ref RobertLucian/GoPiGo#6 : feature - adapted easygopigo to new i2cmutex
    * ref RobertLucian/GoPiGo#6 : feature - solved bug with reset_speed method
    * ref #6 : feature - added mutex one liners
    * ref RobertLucian/GoPiGo#6 : feature - adding object-oriented I2C_mutex
    * ref RobertLucian/GoPiGo#6 : feature - adapted easygopigo to new i2cmutex
    * ref RobertLucian/GoPiGo#6 : feature - solved bug with reset_speed method
    * ref #6 : feature - added mutex one liners
    * ref RobertLucian/GoPiGo#6 : feature - separate functions for I2C mutex
    * used functions for acq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
    [easygopigo.py]
2017-10-30 Some cleanup in new mutex (#277)
    * Some phantom lines ha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
    [easygopigo.py]
2017-11-01 Fix mutex (#278)
    * Some phantom lines had reappeared. I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
2017-11-15 ref RobertLucian/GoPiGo#8 : feature - print function error fixed
2017-12-04 Flip Develop into Master / DexterOS 1.2 (#279)
    [easygopigo.py]
2018-02-02 Bring Develop into Master (#284)
    * ref RobertLucian/GoPiGo#8 : hotfix - used alternative library that doesn't do repeated starts
    * ref RobertLucian/GoPiGo#8 : hotfix - corrected name of dependency
    * ref RobertLucian/GoPiGo#8 : hotfix - cured some syntax errors
    * ref RobertLucian/GoPiGo#8 : hotfix - removing import line that's causing errors + rms unnecessaries
    * ref RobertLucian/GoPiGo#8 : hotfix - removed python2 support and added python3 + added adequate shebangs
    * ref RobertLucian/GoPiGo#8 : hotfix - removed support for Python2
    * Revert "ref RobertLucian/GoPiGo#8 : hotfix - removed support for Python2"
    This reverts commit 46be6762e3cb9f63cfb06d45d2910333f557c647.
    *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
    [easygopigo.py]
2018-02-06 hotfix - bad print format caused by old python version (#285)
    * hotfix - bad print format caused by old python
    * hotfix - some syntax errors in firmware checker
2018-02-09 Add led_toggle to header (#286)
    * constant i2c filename and addresses
    * clear whitespaces
    * make 'led_toggle' available in header
2018-02-14 Remove i2c_mutex, it is now residing in script_tools (#287)
2018-02-15 Feature/easygopigo refactoring (#288)
    * read_position_str() is also needed here to keep in sync with easygopigo3
    * Add init_<sensor> methods to the easygopigo class so the two robots are kept in sync
    * add vscode to .gitignore
2018-03-06 Fix/overallmutexcheck (#292)
    * Query overallmutex flag every single time
    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
    [easygopigo.py]
2018-03-20 fix - remove arduino support (#293)
2018-03-22 hotfix - remove I2C_mutex and overwrite the packages on every installation (#294)
2018-04-20 Capture exceptions from I2CFactory
    Fixes issue #211
    [Board.java]
2018-04-26 flip develop to master branch for DexterOS (#304)
    * Remove i2c_mutex, it is now residing in script_tools (#287)
    * Feature/easygopigo refactoring (#288)
    * Feature/systemwide mutex (#290)
    * support systemwide mutex
    * Bug/line follower + overall mutex (#291)
    * support systemwide mutex
    * Fix import line to its more generic form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
    [easygopigo.py]
2018-04-26 Sync master into develop (#305)
    * Fix Mutex update (#303)
    * flip develop to master branch for DexterOS (#304)
    * suppor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
2018-05-10 feature - change the way the install script installs the robot (#308)
    * feature - add in bulk changes to the installer scripts
    * feature - redefining variables and procedures in install script
    * feature - add function for installing a python package and other stuff
    * feature - changing just a comment
    * feature - change when to exit based on what executable is present
    * feature - revert a check for git presence
    * feature - exit installer if script_tools fails
    * feature - go without using pip for installing large packages
    * feature - fix errors during installation phase
    * feature - uninstall python packages directly without pip
    * feature - fix syntax error in bash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
    [gopigo_status.py]
2018-06-01 release - take the develop branch into master (#312)
    * Fix import line to its more generic for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
    [easygopigo.py, gopigo_status.py]
2019-02-27 use sw i2c instead of hw i2c
2019-02-27 feed int values instead of a list -> cause of error
    [gopigo.py]
2019-03-05 returning -1 triggers "Looking for Sensor" in Bloxter
2019-03-08 hotfix - use SW I2C instead of the Raspberry Pi's HW I2C (#320)
    * use sw i2c instead of hw i2c
    * feed int values instead of a list -> cause of error
    [gopigo.py]
